CogniPilot/spinali_kicad_libs/README.md

# spinali_kicad_libs
For use in kicad8 or greater.

## Steps to use

Run the python script add_lib.py, for more input options pass -h.
