CogniPilot/spinali_kicad_libs/3dmodels/BMxxB-SRSR-TB/BM03B-SRSS-TB.STEP

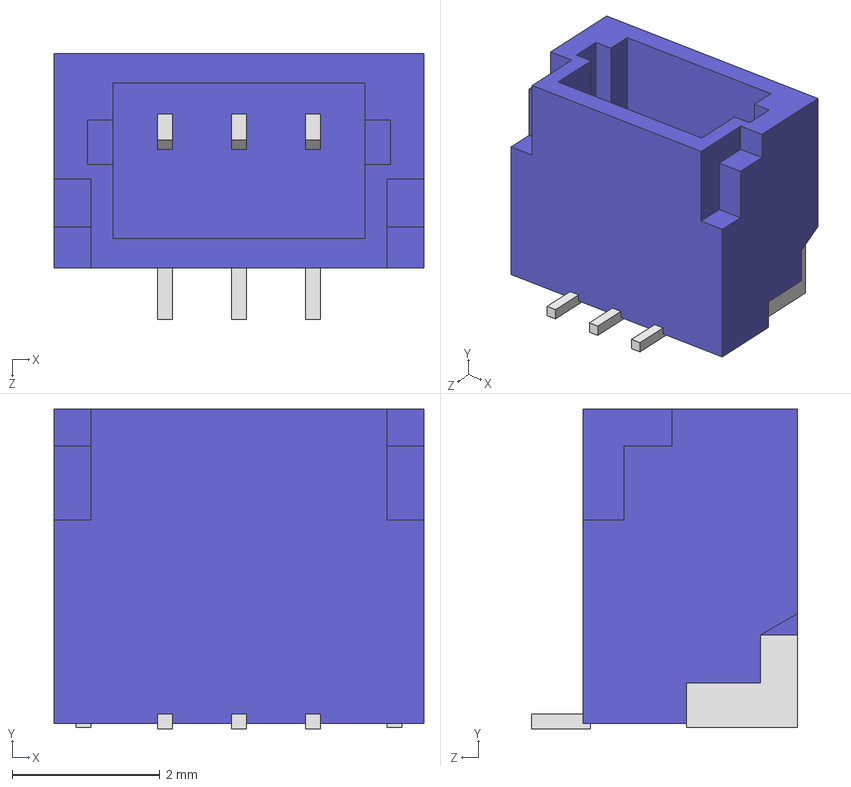
[picture p1: CAD file, 2025-08-25]
3dmodels/BMxxB-SRSR-TB/BM03B-SRSS-TB.STEP
5.00 x 4.32 x 3.60 mm
