CogniPilot/spinali_kicad_libs/3dmodels/SHR-xxV-S/SHR-11V-S.STEP

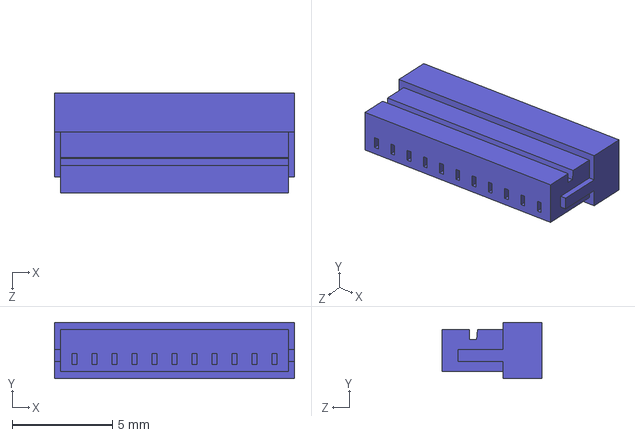
[picture p3: CAD file, 2025-08-25]
3dmodels/SHR-xxV-S/SHR-11V-S.STEP
12.0 x 2.80 x 5.00 mm
