CogniPilot/spinali_kicad_libs/3dmodels/SMxxB-SRSS-TB/SM13B-SRSS-TB.STEP

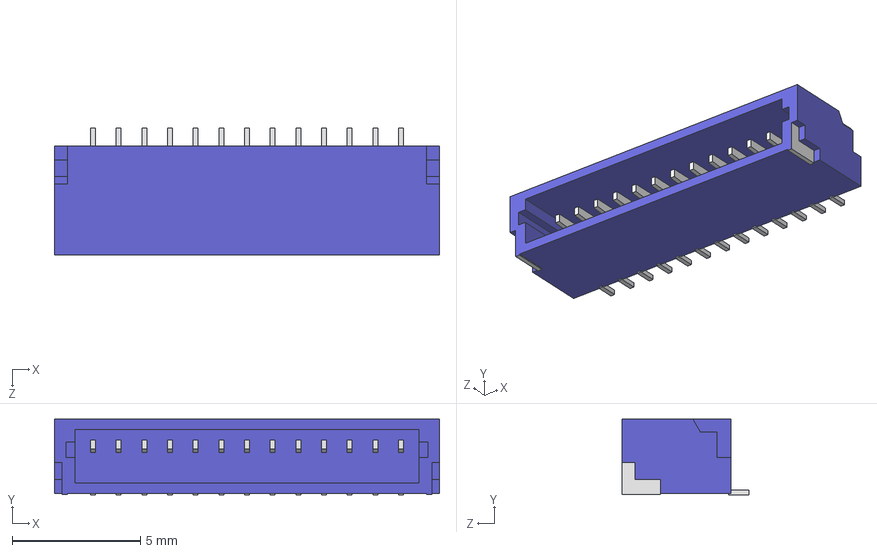
[picture p4: CAD file, 2025-08-25]
3dmodels/SMxxB-SRSS-TB/SM13B-SRSS-TB.STEP
15.0 x 2.96 x 4.95 mm
