CogniPilot/spinali_kicad_libs/3dmodels/SSH-003T-P0.2-H/SSH-003T-P0.2-H.STEP

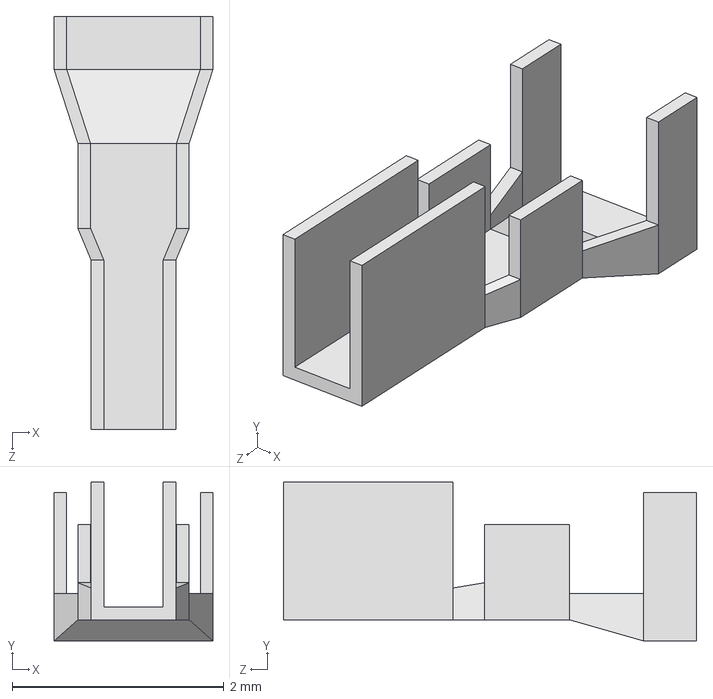
[picture p5: CAD file, 2025-08-25]
3dmodels/SSH-003T-P0.2-H/SSH-003T-P0.2-H.STEP
1.50 x 1.50 x 3.90 mm
