CogniPilot/spinali_kicad_libs/3dmodels/BMxxB-SRSR-TB/BM15B-SRSS-TB.STEP

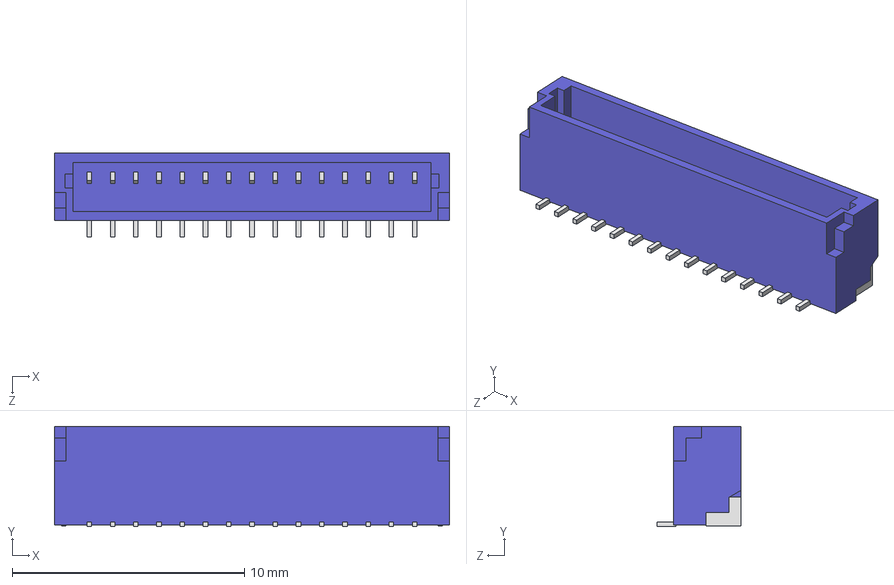
[picture p14: CAD file, 2025-08-25]
3dmodels/BMxxB-SRSR-TB/BM15B-SRSS-TB.STEP
17.0 x 4.32 x 3.60 mm
