CogniPilot/spinali_kicad_libs/3dmodels/GHR-04V-S.STEP

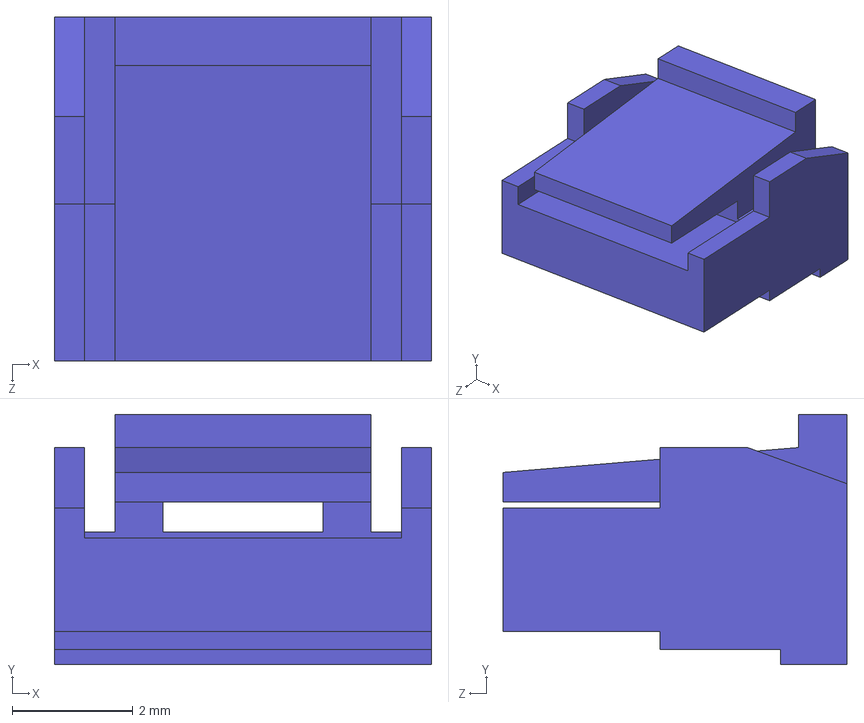
[picture p15: CAD file, 2025-08-25]
3dmodels/GHR-04V-S.STEP
6.25 x 4.15 x 5.70 mm
