CogniPilot/spinali_kicad_libs/3dmodels/SHR-xxV-S-B/SHR-04V-S-B.STEP

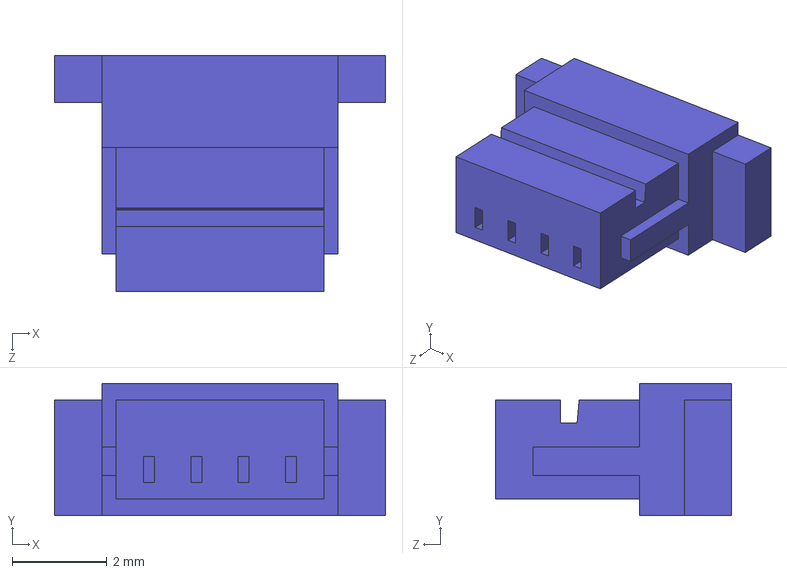
[picture p16: CAD file, 2025-08-25]
3dmodels/SHR-xxV-S-B/SHR-04V-S-B.STEP
7.00 x 2.80 x 5.00 mm
