CogniPilot/spinali_kicad_libs/3dmodels/EVQPU-LC-02K.STEP

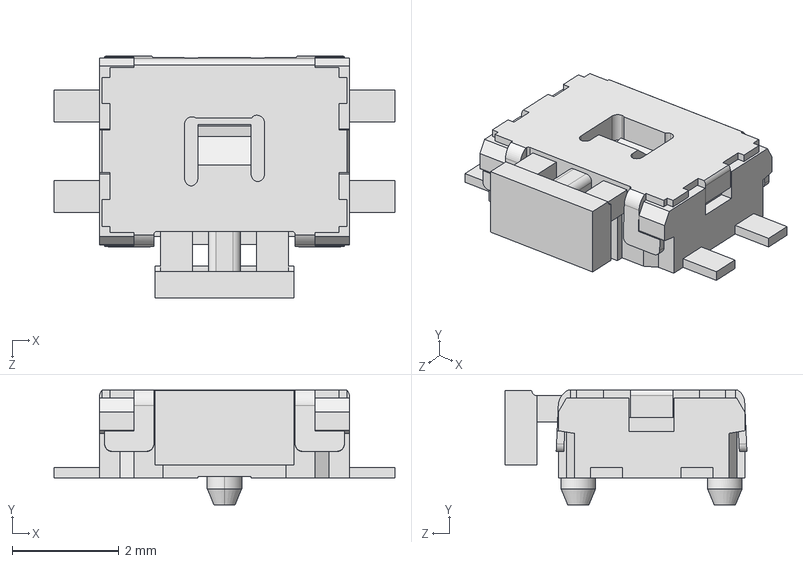
[picture p20: CAD file, 2025-08-21]
3dmodels/EVQPU-LC-02K.STEP
6.40 x 2.15 x 4.54 mm
