CogniPilot/spinali_kicad_libs/3dmodels/SHR-xxV-S/SHR-03V-S.STEP

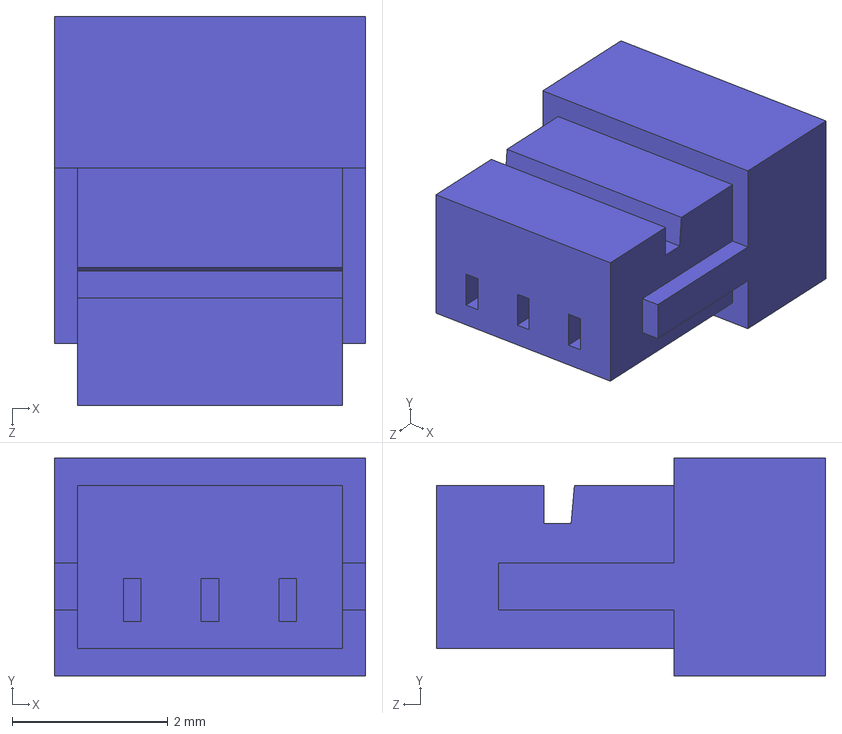
[picture p22: CAD file, 2025-08-25]
3dmodels/SHR-xxV-S/SHR-03V-S.STEP
4.00 x 2.80 x 5.00 mm
