CogniPilot/spinali_kicad_libs/3dmodels/SMxxB-SRSS-TB/SM03B-SRSS-TB.STEP

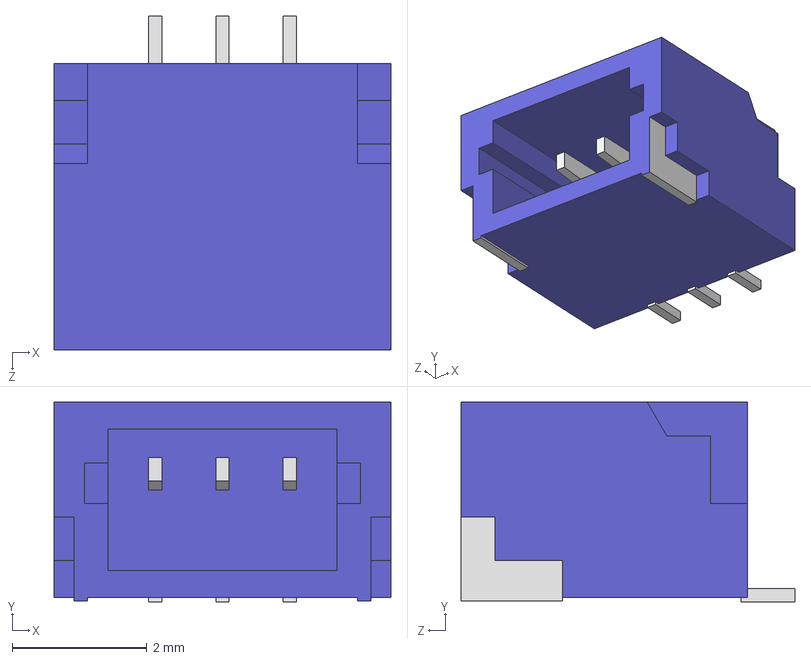
[picture p23: CAD file, 2025-08-25]
3dmodels/SMxxB-SRSS-TB/SM03B-SRSS-TB.STEP
5.00 x 2.96 x 4.95 mm
