CogniPilot/spinali_kicad_libs/3dmodels/NEO-F9P-15B.stp

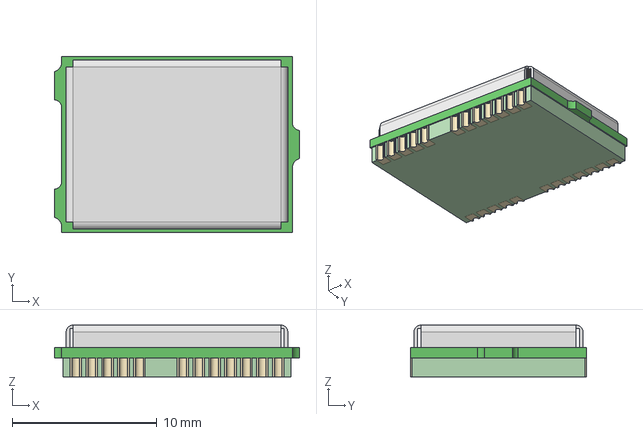
[picture p25: CAD file, 2025-07-10]
3dmodels/NEO-F9P-15B.stp
16.9 x 12.2 x 3.59 mm
