CogniPilot/spinali_kicad_libs/3dmodels/SHR-xxV-S-B/SHR-07V-S-B.STEP

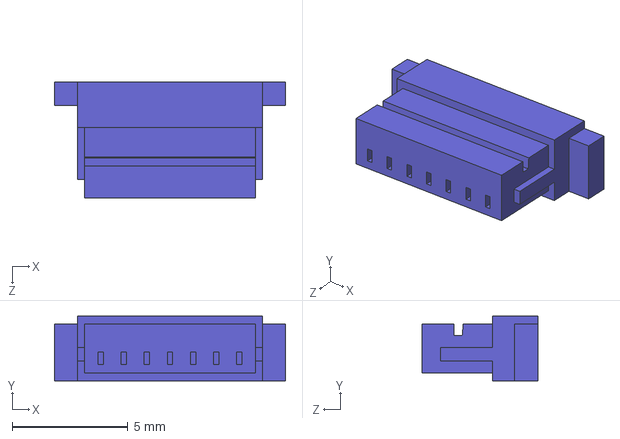
[picture p26: CAD file, 2025-08-25]
3dmodels/SHR-xxV-S-B/SHR-07V-S-B.STEP
10.0 x 2.80 x 5.00 mm
