CogniPilot/spinali_kicad_libs/3dmodels/BMxxB-SRSR-TB/BM10B-SRSS-TB.STEP

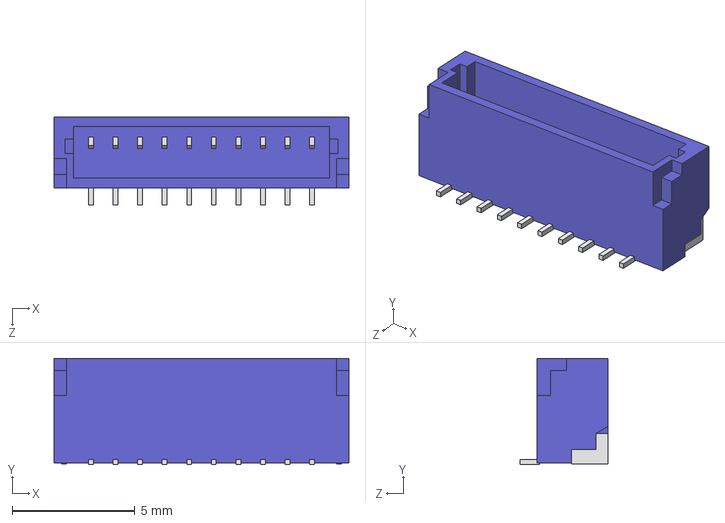
[picture p29: CAD file, 2025-08-25]
3dmodels/BMxxB-SRSR-TB/BM10B-SRSS-TB.STEP
12.0 x 4.32 x 3.60 mm
