CogniPilot/spinali_kicad_libs/3dmodels/PAA3905E1-Q.STEP

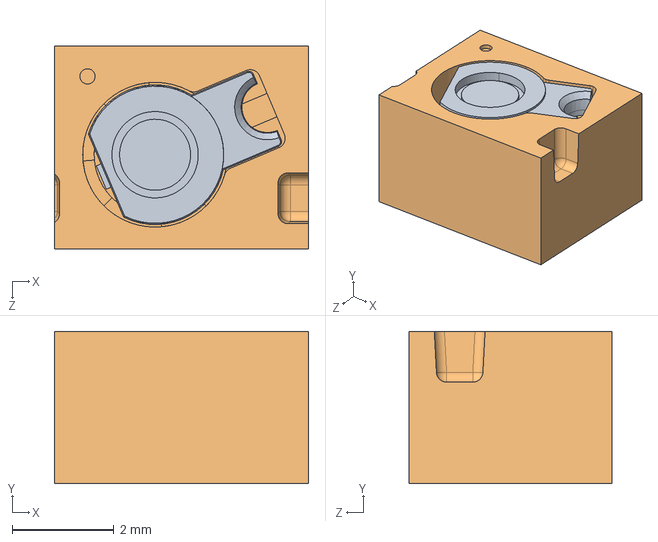
[picture p30: CAD file, 2025-04-24]
3dmodels/PAA3905E1-Q.STEP
5.00 x 3.00 x 4.00 mm
