CogniPilot/spinali_kicad_libs/3dmodels/SMxxB-SRSS-TB/SM02B-SRSS-TB.STEP

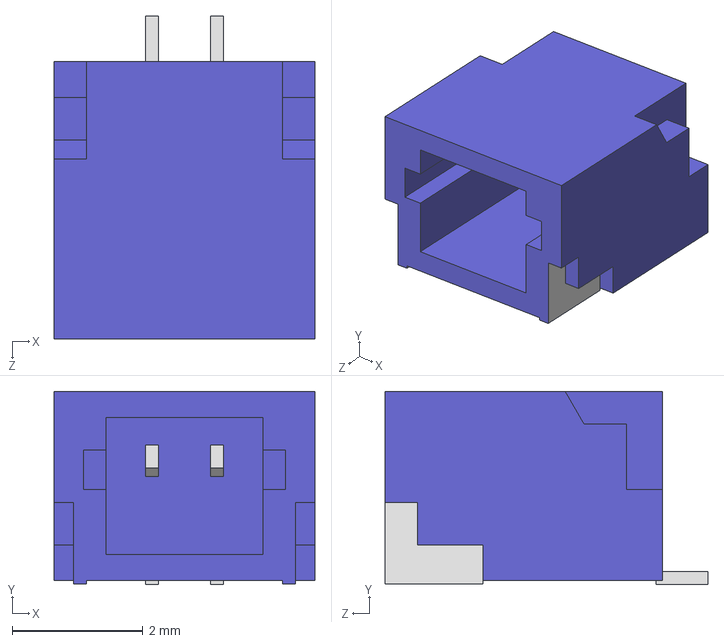
[picture p33: CAD file, 2025-08-25]
3dmodels/SMxxB-SRSS-TB/SM02B-SRSS-TB.STEP
4.00 x 2.96 x 4.95 mm
