CogniPilot/spinali_kicad_libs/3dmodels/ICM-42688-P.stp

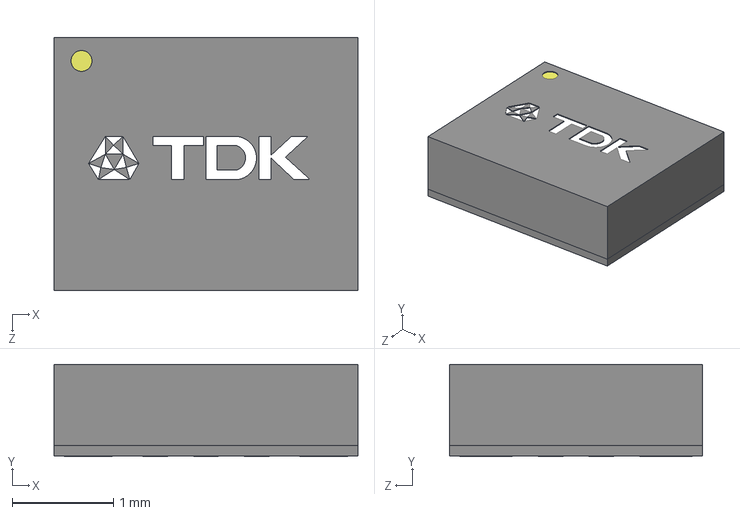
[picture p35: CAD file, 2025-04-23]
3dmodels/ICM-42688-P.stp
3.00 x 0.91 x 2.50 mm
