CogniPilot/spinali_kicad_libs/3dmodels/SHR-xxV-S-B/SHR-05V-S-B.STEP

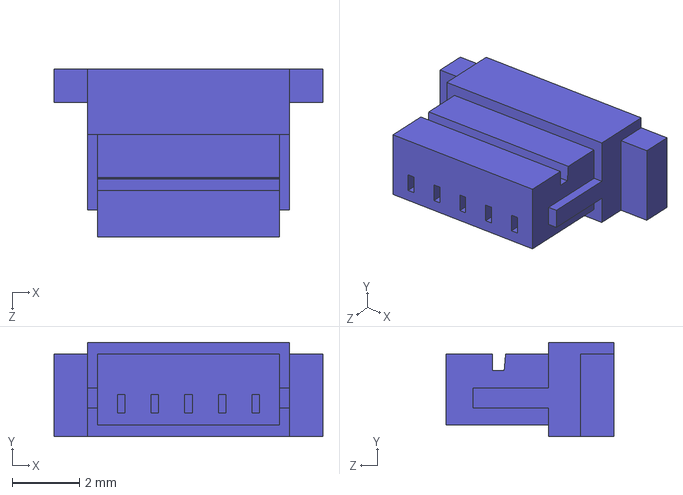
[picture p36: CAD file, 2025-08-25]
3dmodels/SHR-xxV-S-B/SHR-05V-S-B.STEP
8.00 x 2.80 x 5.00 mm
