CogniPilot/spinali_kicad_libs/3dmodels/SMxxB-SRSS-TB/SM06B-SRSS-TB.STEP

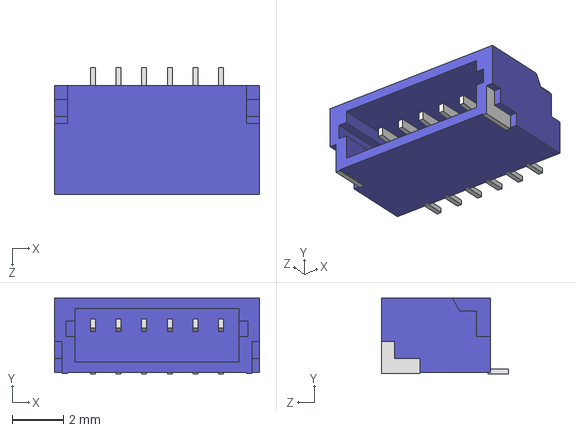
[picture p38: CAD file, 2025-08-25]
3dmodels/SMxxB-SRSS-TB/SM06B-SRSS-TB.STEP
8.00 x 2.96 x 4.95 mm
