CogniPilot/spinali_kicad_libs/3dmodels/ACT1210L-201-2P-TL00.stp

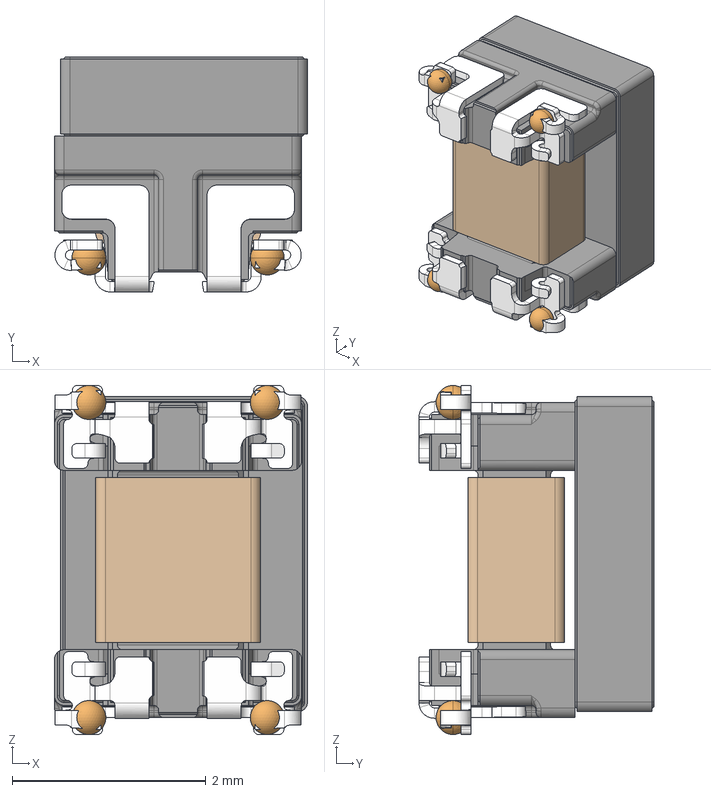
[picture p39: CAD file, 2025-03-26]
3dmodels/ACT1210L-201-2P-TL00.stp
2.61 x 2.42 x 3.60 mm
