CogniPilot/spinali_kicad_libs/3dmodels/BMxxB-SRSR-TB/BM13B-SRSS-TB.STEP

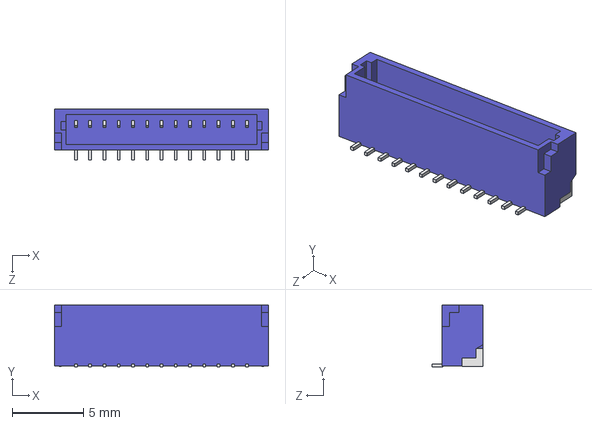
[picture p40: CAD file, 2025-08-25]
3dmodels/BMxxB-SRSR-TB/BM13B-SRSS-TB.STEP
15.0 x 4.32 x 3.60 mm
