CogniPilot/spinali_kicad_libs/3dmodels/BMxxB-SRSR-TB/BM11B-SRSS-TB.STEP

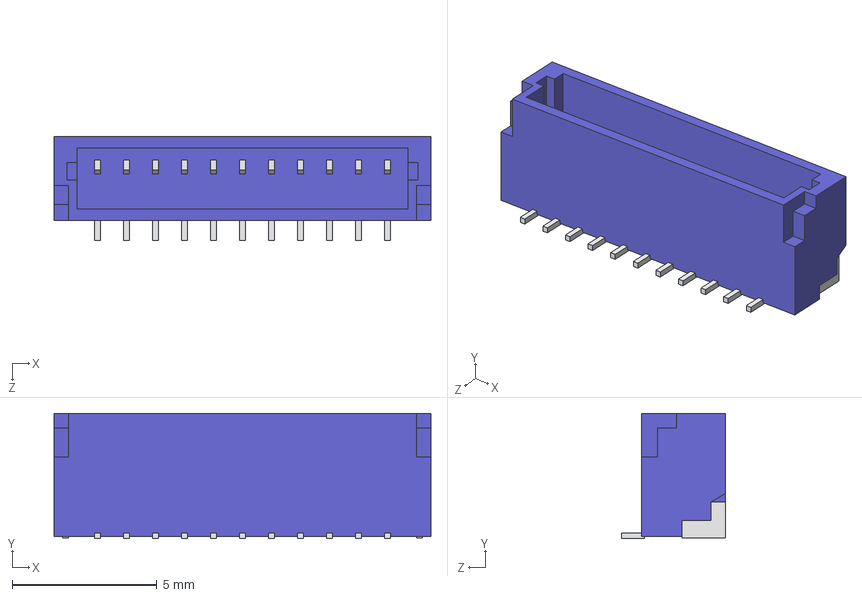
[picture p44: CAD file, 2025-08-25]
3dmodels/BMxxB-SRSR-TB/BM11B-SRSS-TB.STEP
13.0 x 4.32 x 3.60 mm
