CogniPilot/spinali_kicad_libs/3dmodels/SHR-xxV-S/SHR-14V-S.STEP

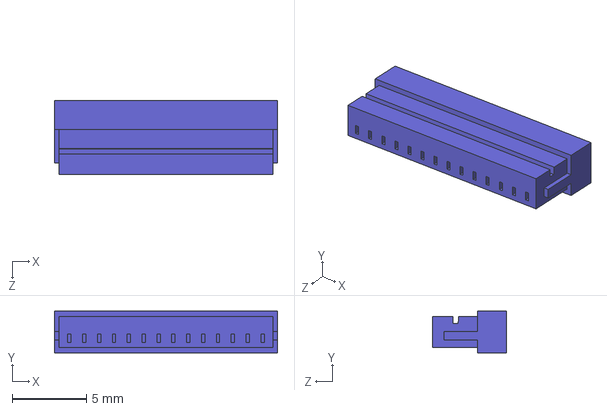
[picture p46: CAD file, 2025-08-25]
3dmodels/SHR-xxV-S/SHR-14V-S.STEP
15.0 x 2.80 x 5.00 mm
