CogniPilot/spinali_kicad_libs/3dmodels/SM10B-SRSS-TB_LF__SN_.stp

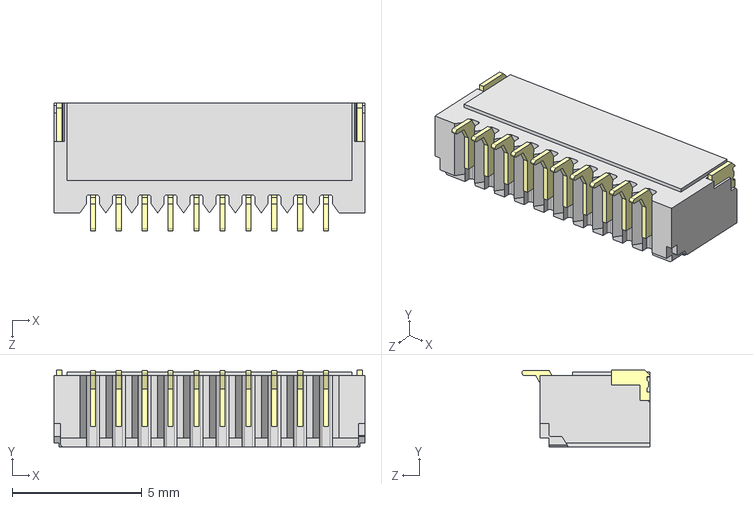
[picture p47: CAD file, 2025-03-20]
3dmodels/SM10B-SRSS-TB_LF__SN_.stp
12.0 x 2.97 x 4.95 mm
