CogniPilot/spinali_kicad_libs/3dmodels/PCMF1USB3SZ.stp

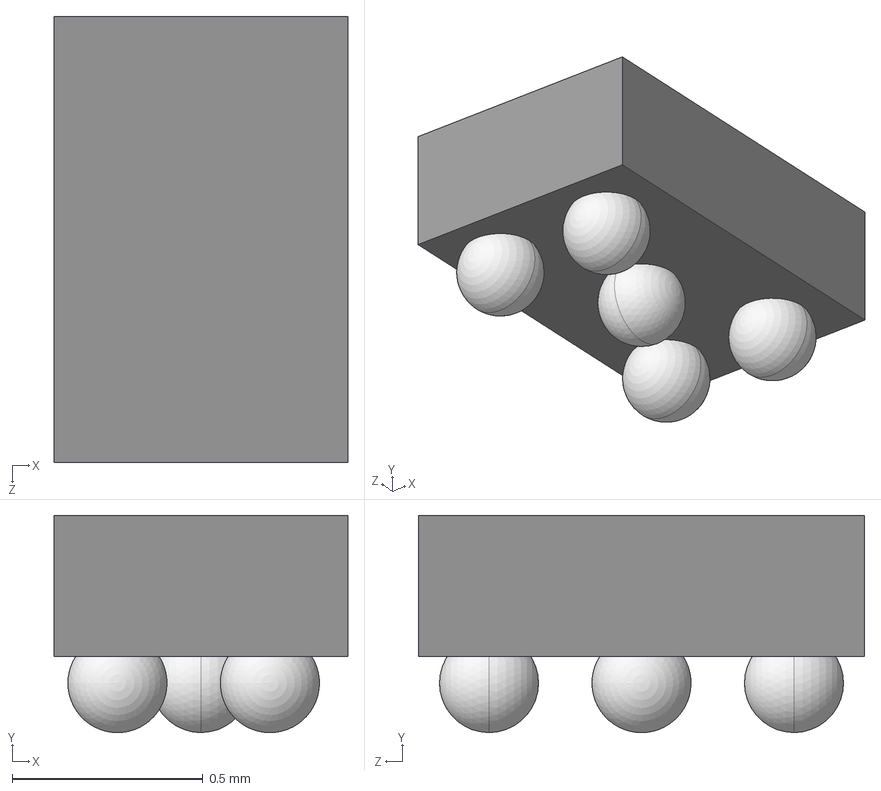
[picture p50: CAD file, 2025-03-20]
3dmodels/PCMF1USB3SZ.stp
0.77 x 0.57 x 1.17 mm
