CogniPilot/spinali_kicad_libs/3dmodels/SHR-xxV-S-B/SHR-20V-S-B.STEP

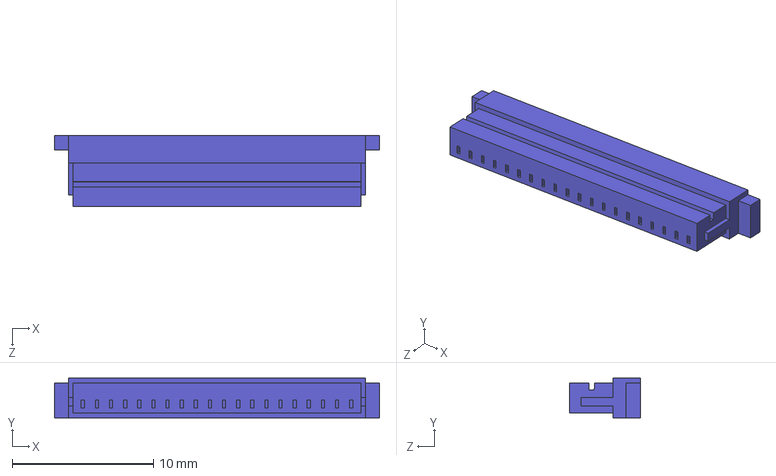
[picture p51: CAD file, 2025-08-25]
3dmodels/SHR-xxV-S-B/SHR-20V-S-B.STEP
23.0 x 2.80 x 5.00 mm
