CogniPilot/spinali_kicad_libs/3dmodels/SHR-xxV-S/SHR-09V-S.STEP

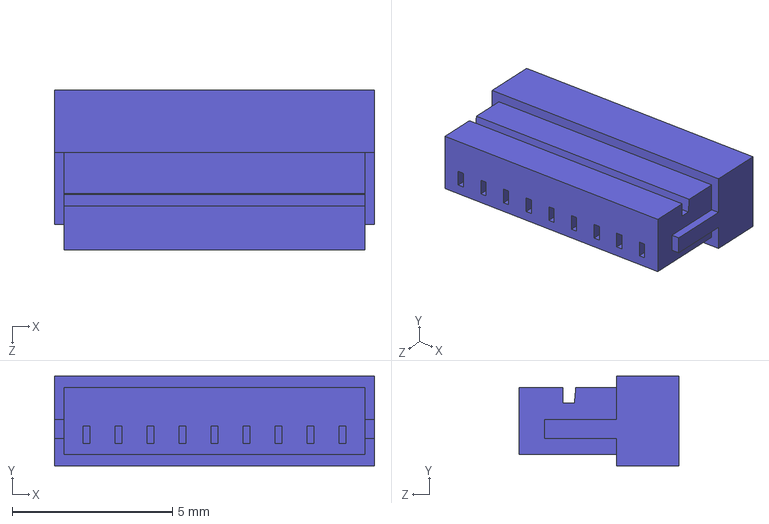
[picture p52: CAD file, 2025-08-25]
3dmodels/SHR-xxV-S/SHR-09V-S.STEP
10.0 x 2.80 x 5.00 mm
