CogniPilot/spinali_kicad_libs/3dmodels/SMxxB-SRSS-TB/SM07B-SRSS-TB.STEP

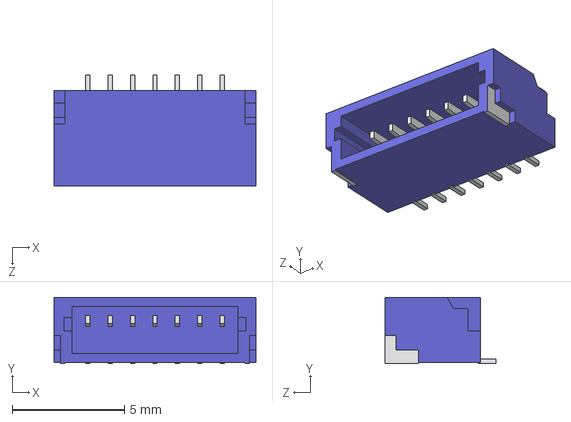
[picture p53: CAD file, 2025-08-25]
3dmodels/SMxxB-SRSS-TB/SM07B-SRSS-TB.STEP
9.00 x 2.96 x 4.95 mm
