CogniPilot/spinali_kicad_libs/3dmodels/6DFN62CA-M3_I.stp

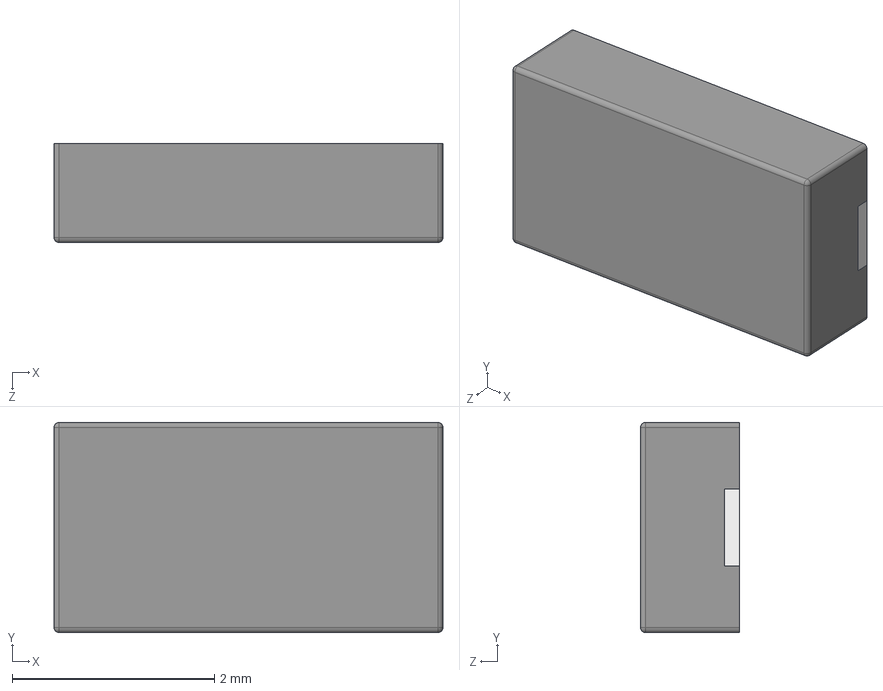
[picture p54: CAD file, 2025-03-20]
3dmodels/6DFN62CA-M3_I.stp
3.85 x 2.08 x 0.98 mm
