CogniPilot/spinali_kicad_libs/3dmodels/SHR-xxV-S-B/SHR-10V-S-B.STEP

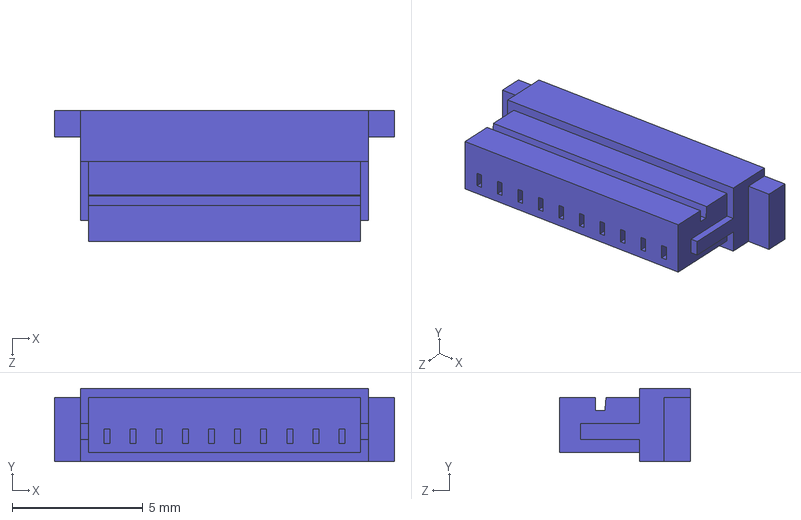
[picture p56: CAD file, 2025-08-25]
3dmodels/SHR-xxV-S-B/SHR-10V-S-B.STEP
13.0 x 2.80 x 5.00 mm
