CogniPilot/spinali_kicad_libs/3dmodels/SHR-xxV-S/SHR-06V-S.STEP

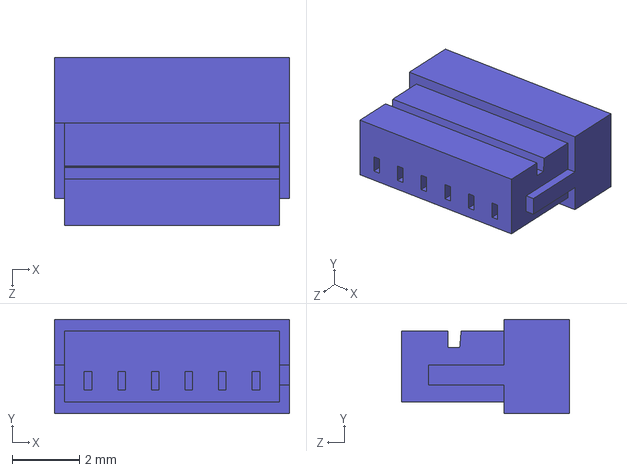
[picture p57: CAD file, 2025-08-25]
3dmodels/SHR-xxV-S/SHR-06V-S.STEP
7.00 x 2.80 x 5.00 mm
