CogniPilot/spinali_kicad_libs/3dmodels/SMxxB-SRSS-TB/SM20B-SRSS-TB.STEP

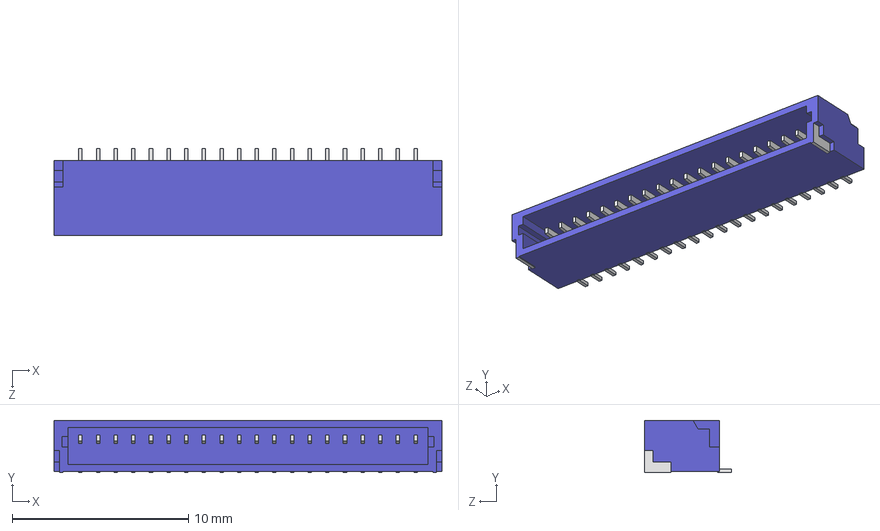
[picture p58: CAD file, 2025-08-25]
3dmodels/SMxxB-SRSS-TB/SM20B-SRSS-TB.STEP
22.0 x 2.96 x 4.95 mm
