CogniPilot/spinali_kicad_libs/3dmodels/BMxxB-SRSR-TB/BM08B-SRSS-TB.STEP

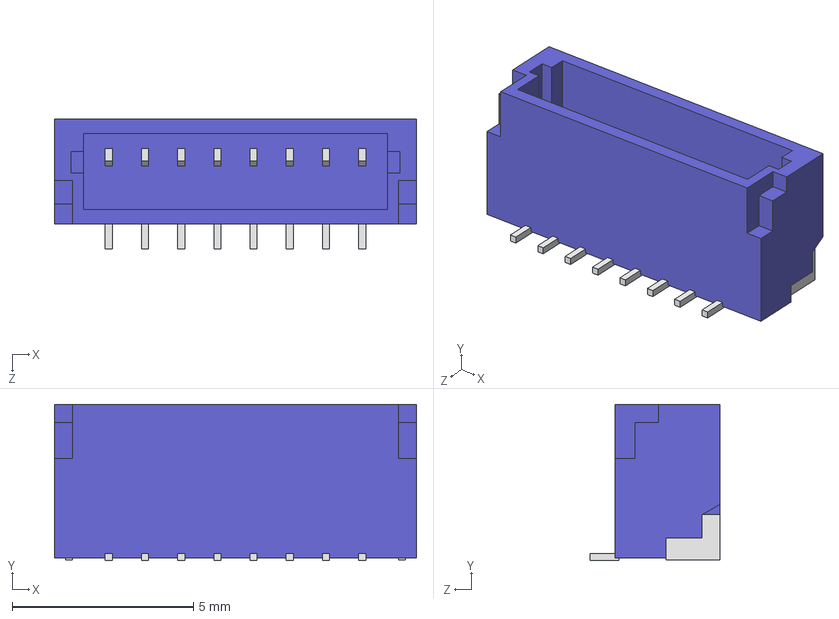
[picture p59: CAD file, 2025-08-25]
3dmodels/BMxxB-SRSR-TB/BM08B-SRSS-TB.STEP
10.0 x 4.32 x 3.60 mm
