CogniPilot/spinali_kicad_libs/3dmodels/PCMF3USB3S_CZ.stp

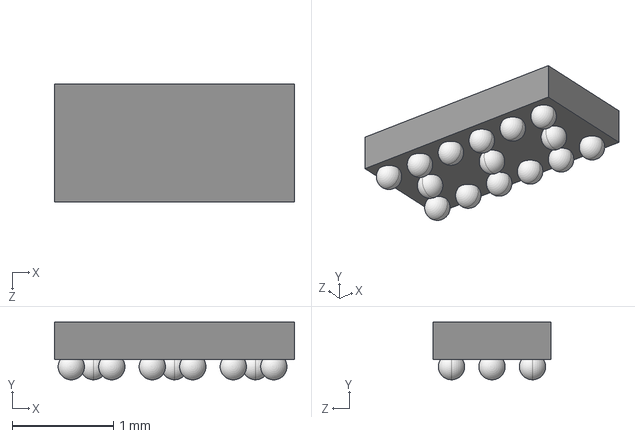
[picture p60: CAD file, 2025-03-20]
3dmodels/PCMF3USB3S_CZ.stp
2.37 x 0.57 x 1.17 mm
