CogniPilot/spinali_kicad_libs/3dmodels/SHR-xxV-S-B/SHR-08V-S-B.STEP

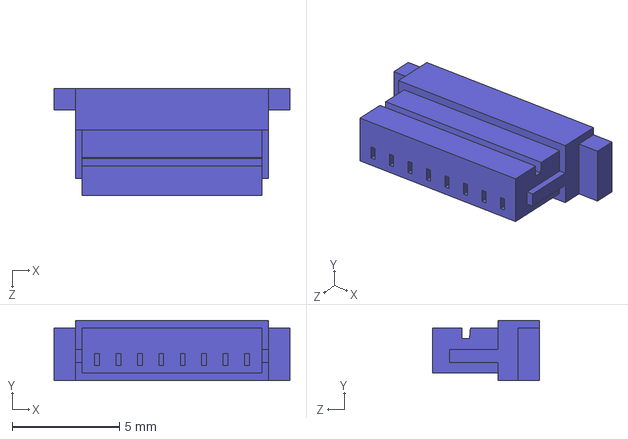
[picture p61: CAD file, 2025-08-25]
3dmodels/SHR-xxV-S-B/SHR-08V-S-B.STEP
11.0 x 2.80 x 5.00 mm
