CogniPilot/spinali_kicad_libs/3dmodels/SHR-xxV-S/SHR-12V-S.STEP

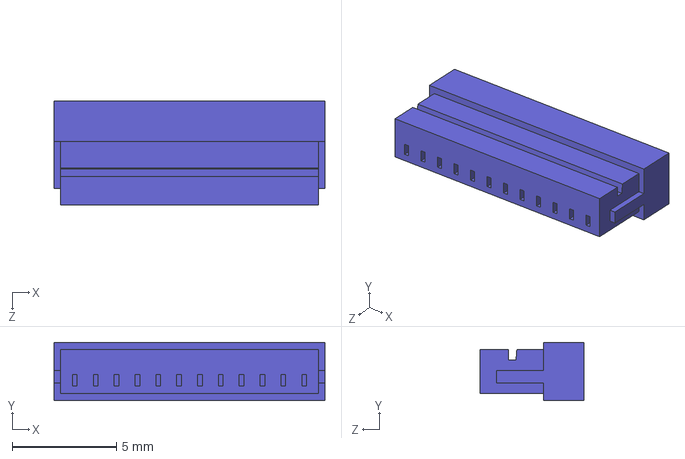
[picture p62: CAD file, 2025-08-25]
3dmodels/SHR-xxV-S/SHR-12V-S.STEP
13.0 x 2.80 x 5.00 mm
