CogniPilot/spinali_kicad_libs/3dmodels/BMxxB-SRSR-TB/BM09B-SRSS-TB.STEP

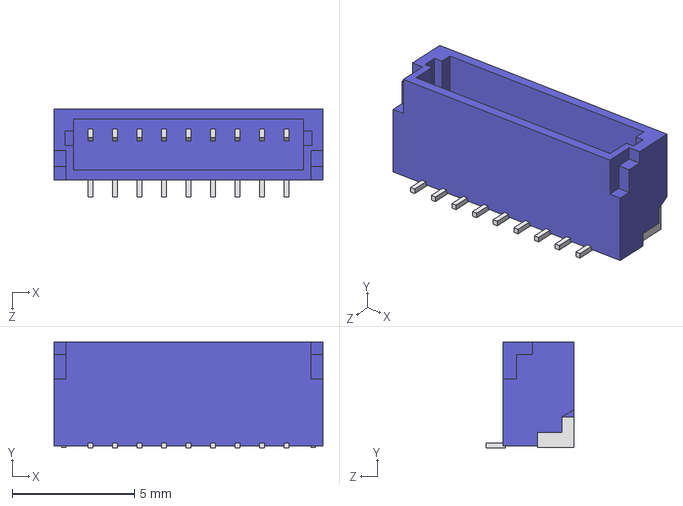
[picture p64: CAD file, 2025-08-25]
3dmodels/BMxxB-SRSR-TB/BM09B-SRSS-TB.STEP
11.0 x 4.32 x 3.60 mm
