CogniPilot/spinali_kicad_libs/3dmodels/SHR-xxV-S-B/SHR-06V-S-B.STEP

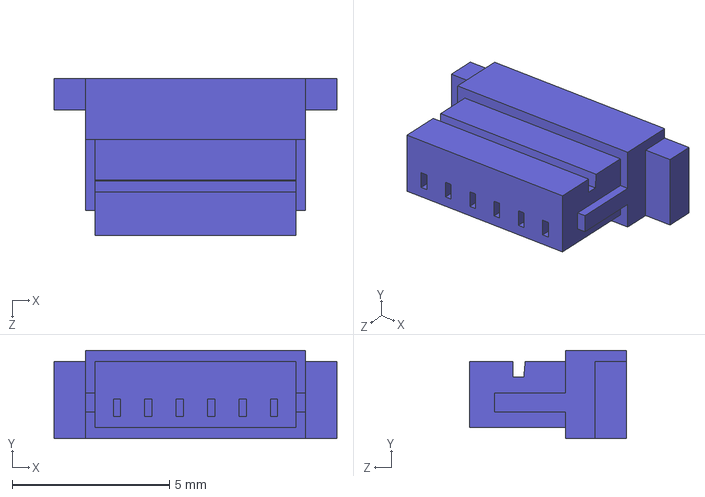
[picture p65: CAD file, 2025-08-25]
3dmodels/SHR-xxV-S-B/SHR-06V-S-B.STEP
9.00 x 2.80 x 5.00 mm
