CogniPilot/spinali_kicad_libs/3dmodels/SMxxB-SRSS-TB/SM12B-SRSS-TB.STEP

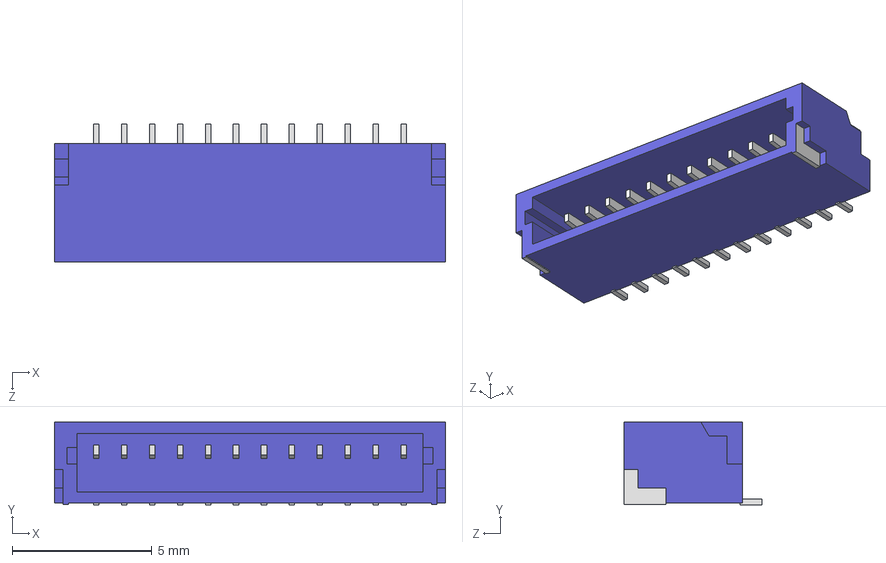
[picture p67: CAD file, 2025-08-25]
3dmodels/SMxxB-SRSS-TB/SM12B-SRSS-TB.STEP
14.0 x 2.96 x 4.95 mm
