CogniPilot/spinali_kicad_libs/3dmodels/PESD5V0S1ULD,315.stp

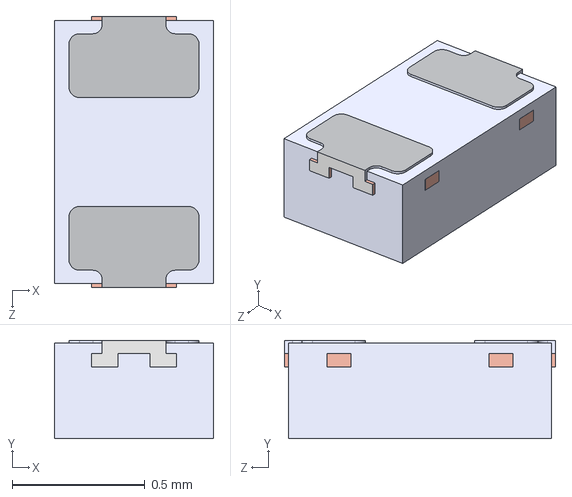
[picture p68: CAD file, 2025-03-20]
3dmodels/PESD5V0S1ULD,315.stp
0.6 x 0.37 x 1.02 mm
SOD882D LF
SOD882D Body
