CogniPilot/spinali_kicad_libs/3dmodels/SMxxB-SRSS-TB/SM10B-SRSS-TB.STEP

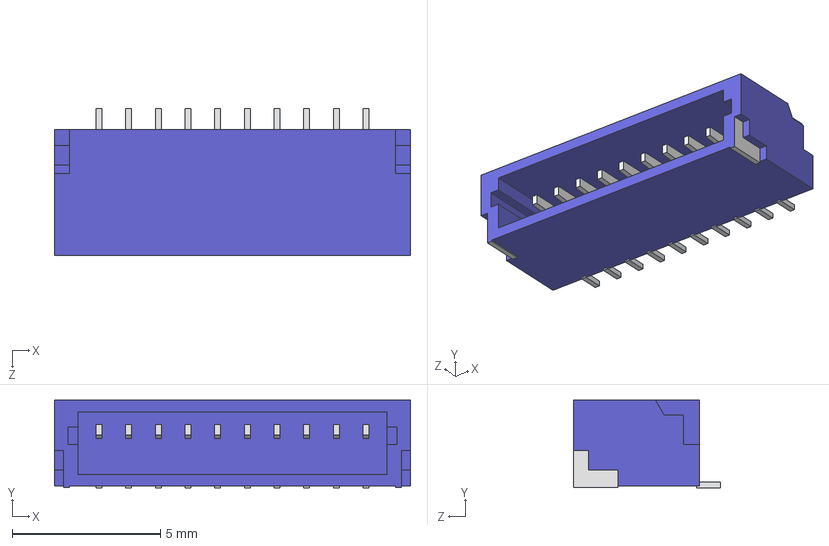
[picture p70: CAD file, 2025-08-25]
3dmodels/SMxxB-SRSS-TB/SM10B-SRSS-TB.STEP
12.0 x 2.96 x 4.95 mm
