CogniPilot/spinali_kicad_libs/3dmodels/TS2306A-240GF-MSM-9_C388290.stp

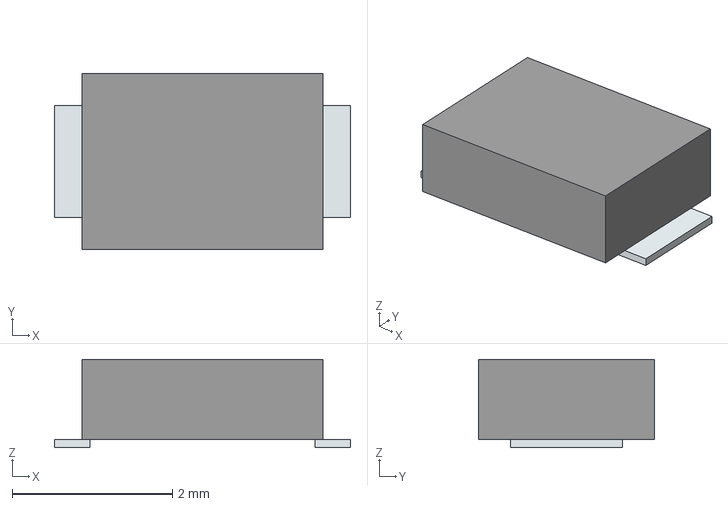
[picture p71: CAD file, 2025-03-20]
3dmodels/TS2306A-240GF-MSM-9_C388290.stp
3.69 x 2.20 x 1.10 mm
Pins
