CogniPilot/spinali_kicad_libs/3dmodels/DF40TC-50DP-0.4V(51).stp

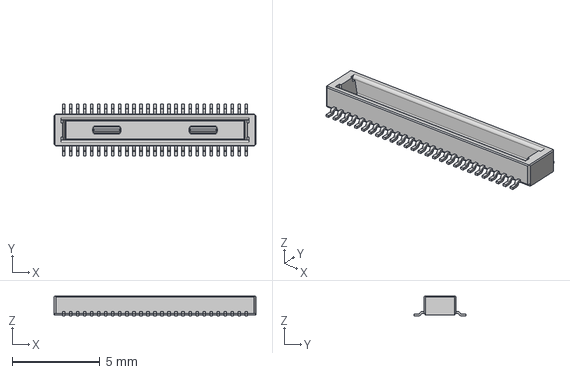
[picture p72: CAD file, 2025-03-18]
3dmodels/DF40TC-50DP-0.4V(51).stp
11.5 x 2.97 x 1.14 mm
