CogniPilot/spinali_kicad_libs/3dmodels/XRCGB25M000F3A00R0.stp

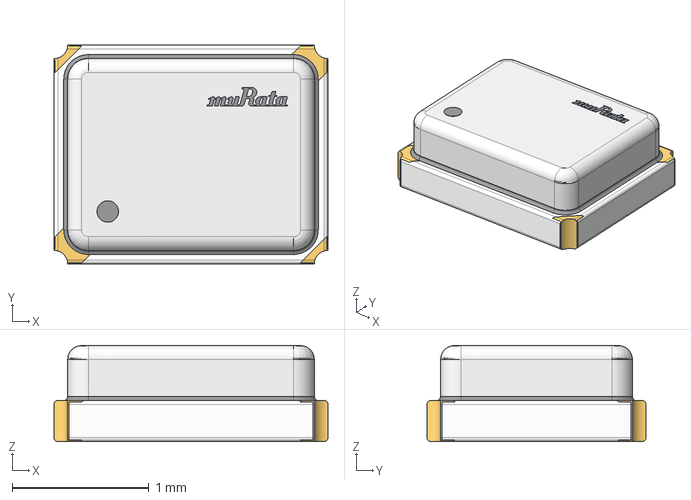
[picture p73: CAD file, 2025-03-18]
3dmodels/XRCGB25M000F3A00R0.stp
2.00 x 1.60 x 0.702 mm
