CogniPilot/spinali_kicad_libs/3dmodels/NANOT160AS.stp

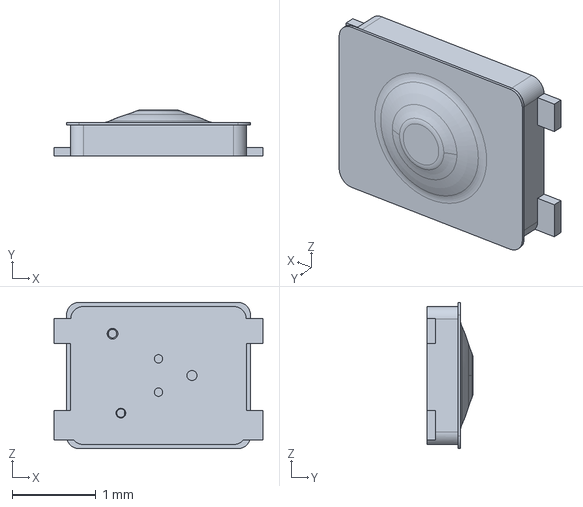
[picture p74: CAD file, 2025-03-18]
3dmodels/NANOT160AS.stp
2.50 x 0.55 x 1.75 mm
