CogniPilot/spinali_kicad_libs/3dmodels/ACM7060-301-2PL-TL01.stp

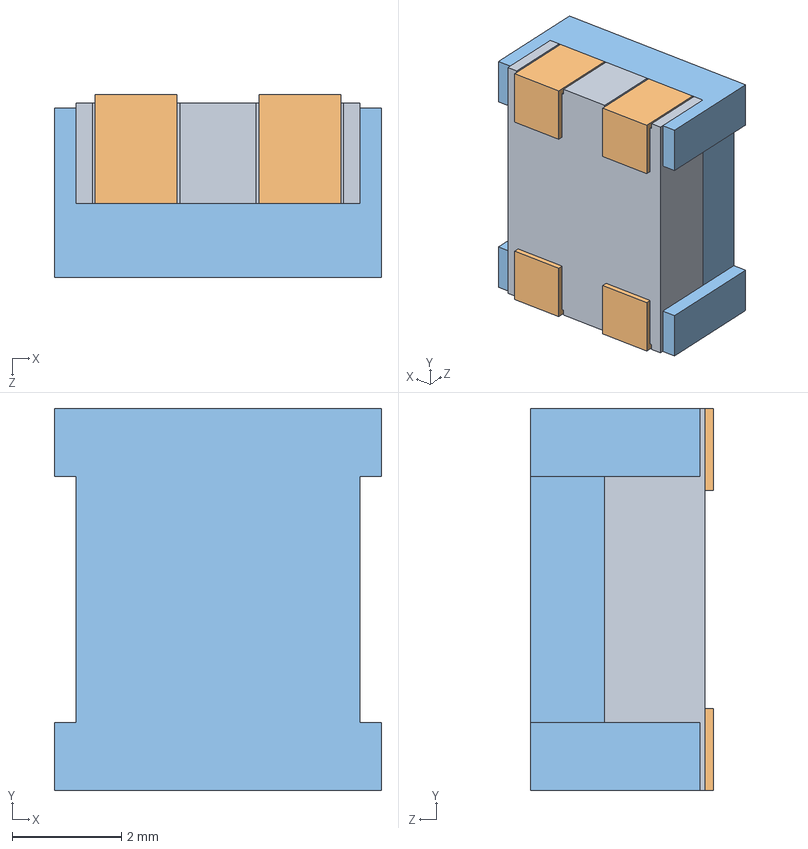
[picture p75: CAD file, 2025-03-18]
3dmodels/ACM7060-301-2PL-TL01.stp
6.00 x 7.00 x 3.35 mm
ACM70Vコアblock(typ size)
ACM70V端子block(typ size) x 4
ACM70Vカバblock(typ size)
