CogniPilot/spinali_kicad_libs/3dmodels/DF40TC(3.0)-50DP-0.4V(51).STEP

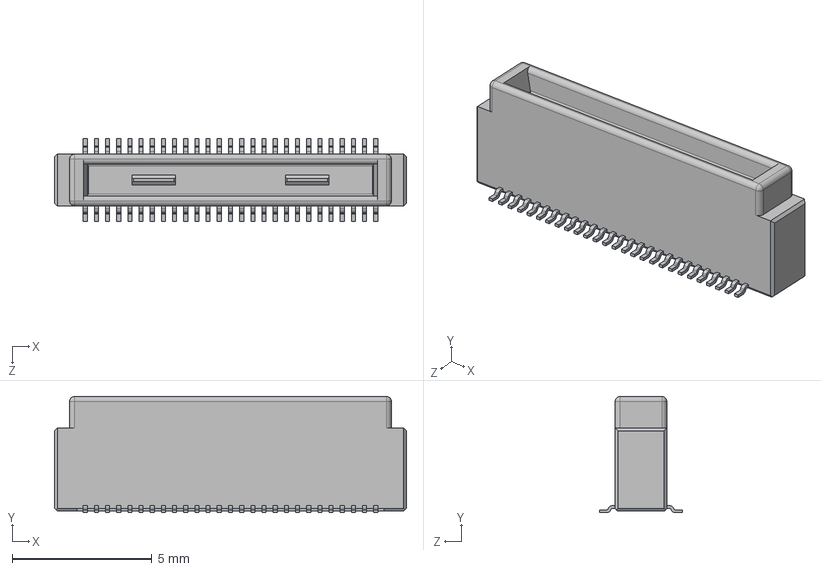
[picture p77: CAD file, 2025-03-18]
3dmodels/DF40TC(3.0)-50DP-0.4V(51).STEP
12.6 x 4.16 x 2.97 mm
