CogniPilot/spinali_kicad_libs/3dmodels/ESD7104MUTAG.stp

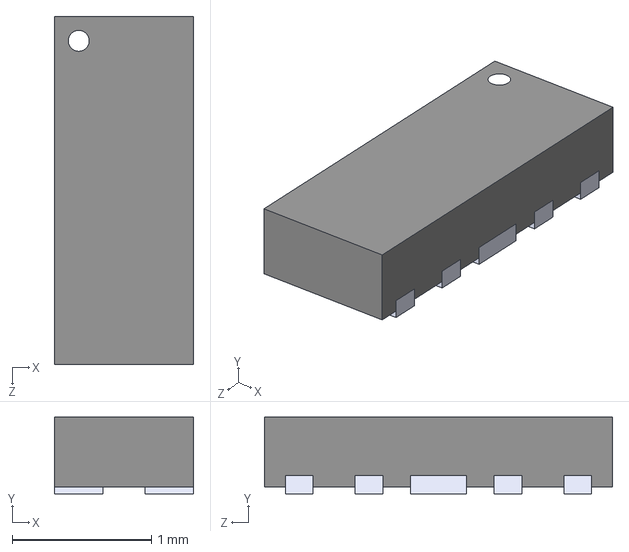
[picture p79: CAD file, 2025-03-18]
3dmodels/ESD7104MUTAG.stp
1.00 x 0.55 x 2.50 mm
