CogniPilot/spinali_kicad_libs/3dmodels/DF40TC(4.0)-50DS-0.4V(51).stp

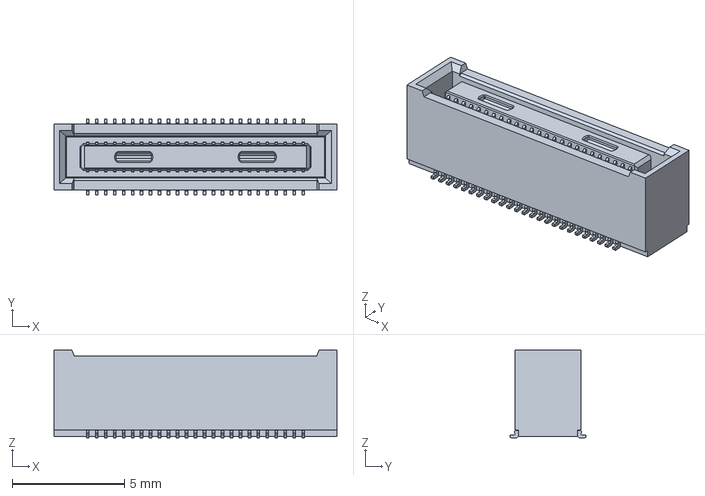
[picture p80: CAD file, 2025-03-18]
3dmodels/DF40TC(4.0)-50DS-0.4V(51).stp
12.6 x 3.38 x 3.90 mm
