CogniPilot/spinali_kicad_libs/3dmodels/IFLN1210BEER512N.stp

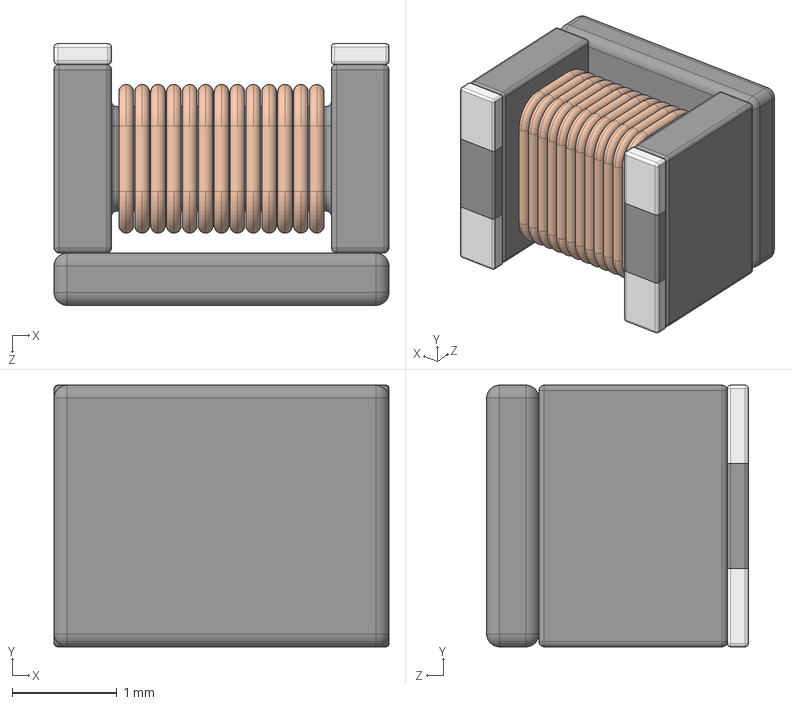
[picture p81: CAD file, 2025-03-13]
3dmodels/IFLN1210BEER512N.stp
3.20 x 2.50 x 2.50 mm
