CogniPilot/spinali_kicad_libs/3dmodels/PESD2IVN24-UX.stp

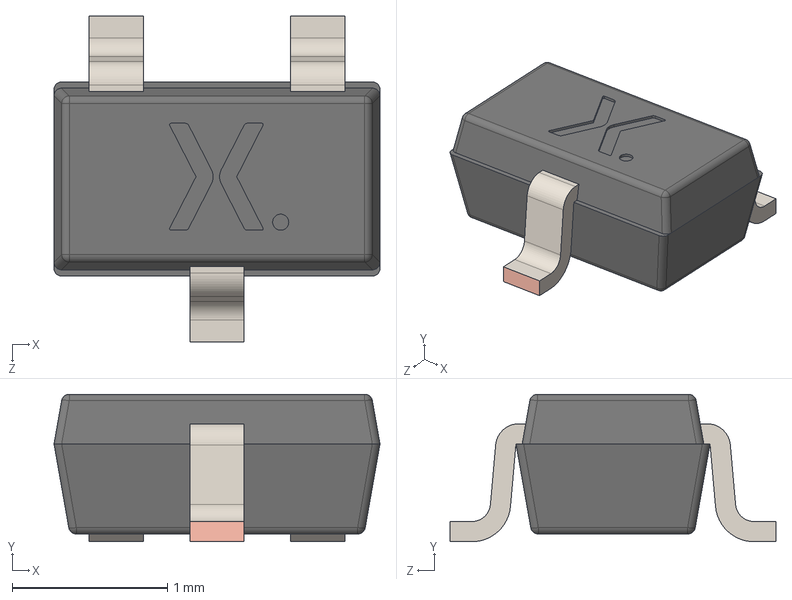
[picture p82: CAD file, 2025-03-12]
3dmodels/PESD2IVN24-UX.stp
2.10 x 0.95 x 2.10 mm
Upper body
lower body
Lead x 3
