CogniPilot/spinali_kicad_libs/3dmodels/BMM350.stp

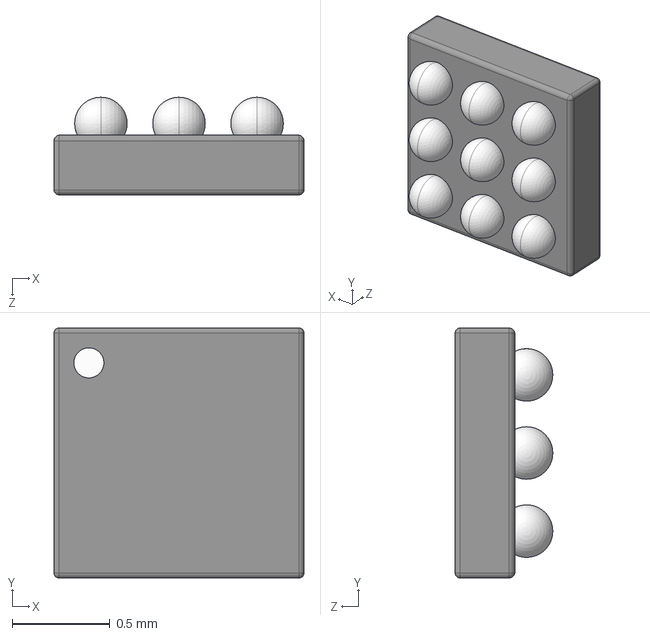
[picture p83: CAD file, 2025-03-12]
3dmodels/BMM350.stp
1.28 x 1.28 x 0.5 mm
