CogniPilot/spinali_kicad_libs/3dmodels/NFM31KC153R1H3L.stp

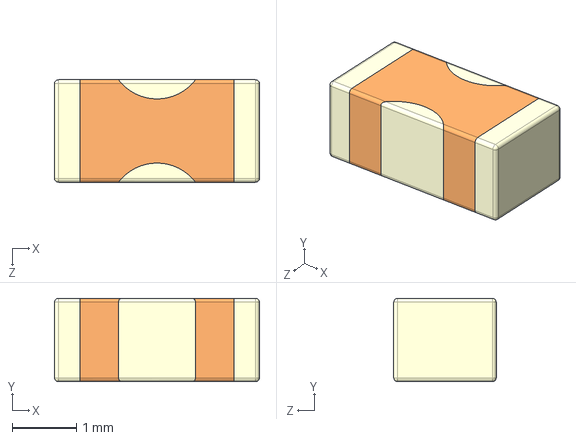
[picture p84: CAD file, 2025-03-12]
3dmodels/NFM31KC153R1H3L.stp
3.20 x 1.30 x 1.60 mm
