CogniPilot/spinali_kicad_libs/3dmodels/BMP581.stp

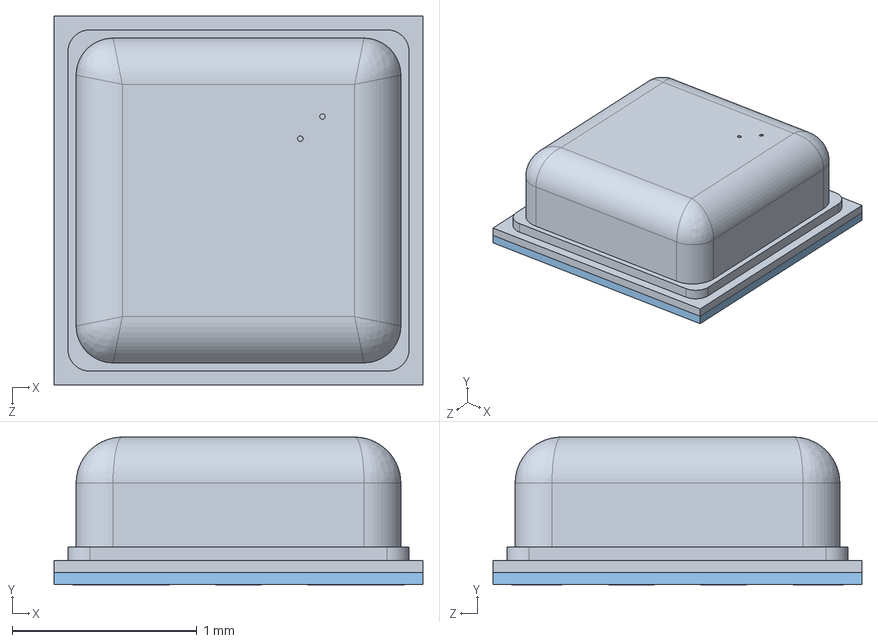
[picture p85: CAD file, 2025-03-12]
3dmodels/BMP581.stp
2.00 x 0.801 x 2.00 mm
