CogniPilot/spinali_kicad_libs/3dmodels/NX5P3363UKZ.stp

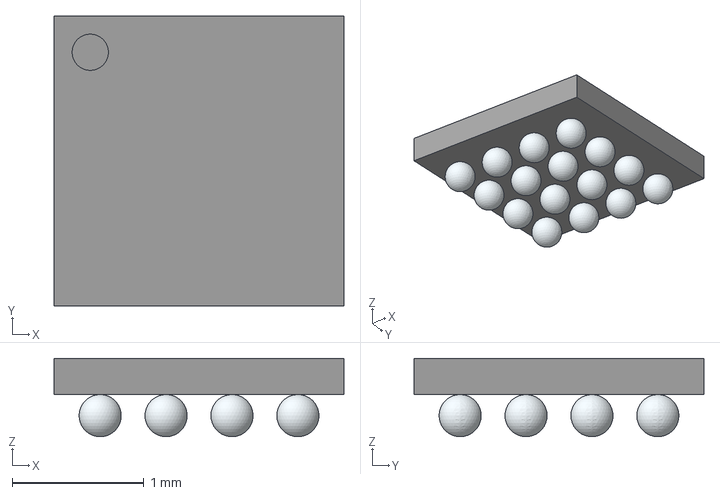
[picture p86: CAD file, 2025-03-12]
3dmodels/NX5P3363UKZ.stp
2.20 x 2.20 x 0.595 mm
