CogniPilot/spinali_kicad_libs/3dmodels/MPM3822CGRH.step

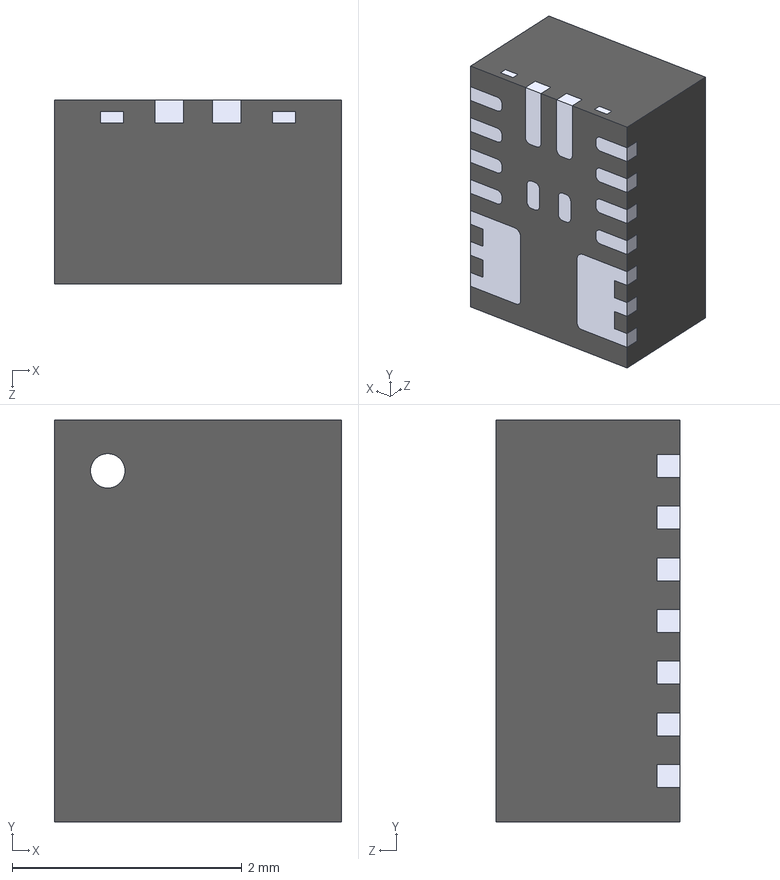
[picture p87: CAD file, 2025-03-12]
3dmodels/MPM3822CGRH.step
2.50 x 3.50 x 1.60 mm
