CogniPilot/spinali_kicad_libs/3dmodels/VQFN32_PHA_MCH.step

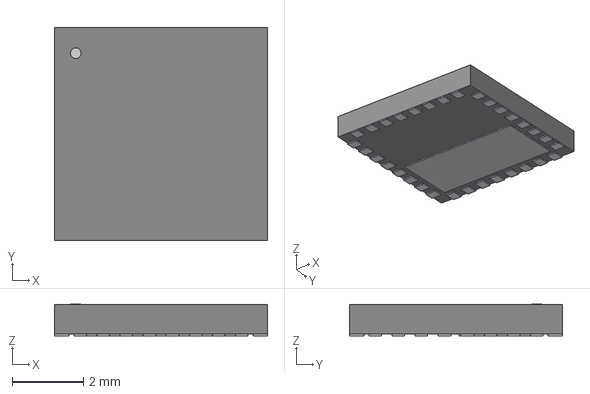
[picture p88: CAD file, 2025-03-12]
3dmodels/VQFN32_PHA_MCH.step
5.99 x 5.99 x 0.892 mm
