CogniPilot/spinali_kicad_libs/3dmodels/ACP3225-102-2P-T000.stp

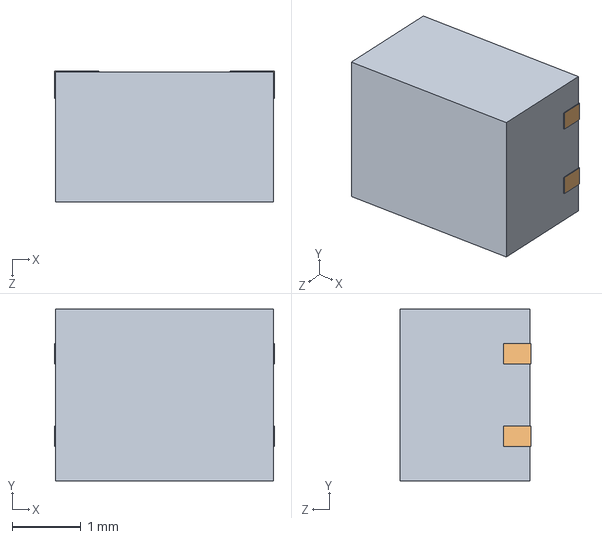
[picture p90: CAD file, 2025-03-12]
3dmodels/ACP3225-102-2P-T000.stp
3.20 x 2.50 x 1.90 mm
ACP3225-T000 DRコアブロック(typ size)
ACP3225-T000 電極ブロック(typ size) x 4
