CogniPilot/spinali_kicad_libs/3dmodels/VLS5045EX-330M-H.stp

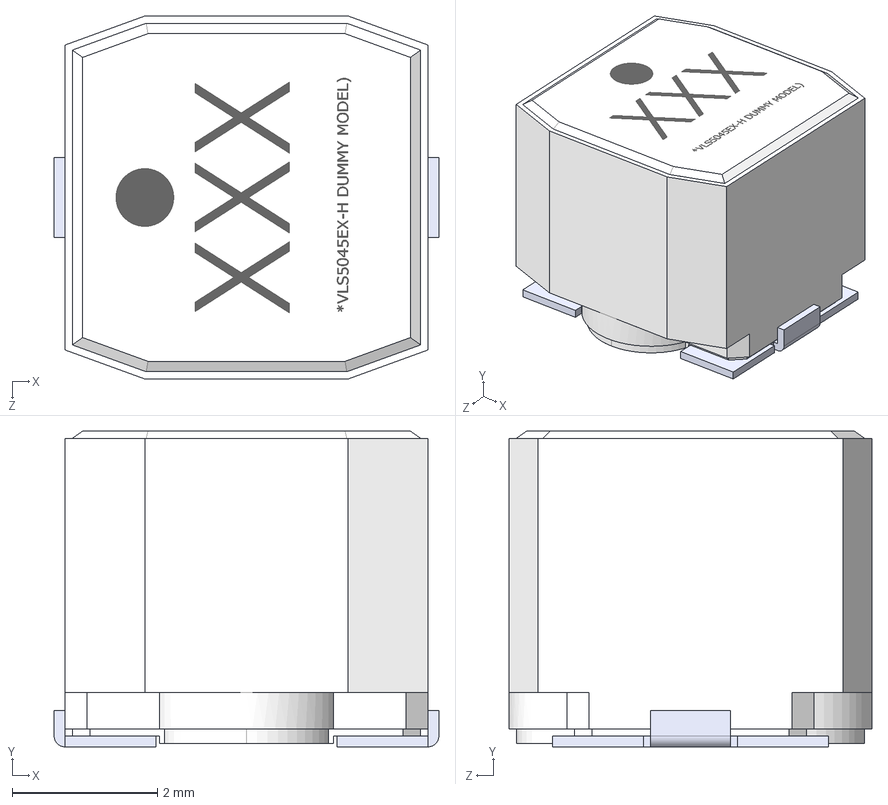
[picture p91: CAD file, 2025-03-12]
3dmodels/VLS5045EX-330M-H.stp
5.30 x 4.35 x 5.00 mm
VLS5045EX-H_C(3Dmodel)
VLS5045EX-H_T(3Dmodel)
