CogniPilot/spinali_kicad_libs/3dmodels/DF40C-30DP-0.4V_51_.stp

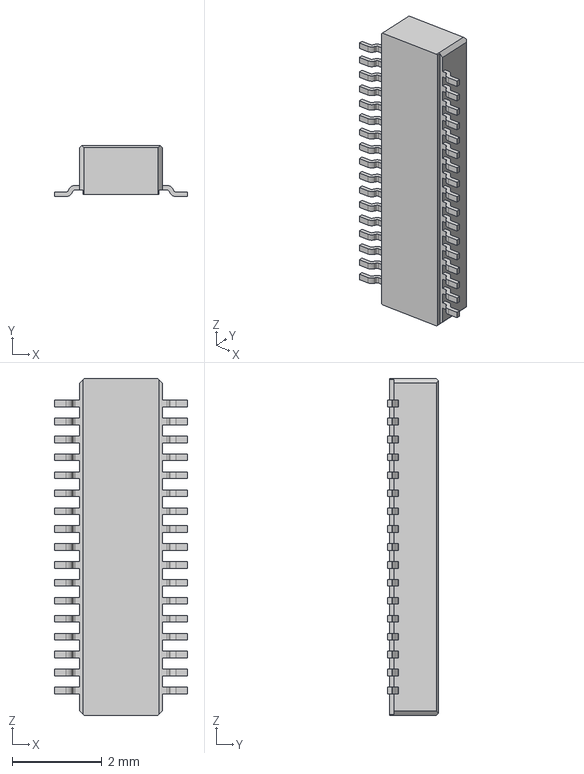
[picture p92: CAD file, 2025-02-22]
3dmodels/DF40C-30DP-0.4V_51_.stp
2.97 x 1.14 x 7.52 mm
