CogniPilot/spinali_kicad_libs/3dmodels/10LGA_2X2X0p75_BOS.step

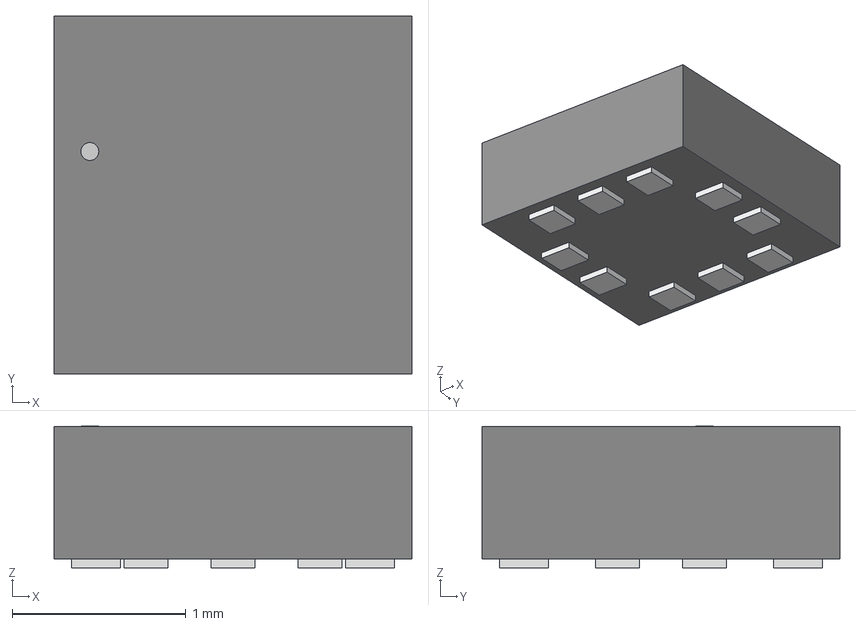
[picture p93: CAD file, 2025-01-15]
3dmodels/10LGA_2X2X0p75_BOS.step
2.06 x 2.06 x 0.815 mm
