CogniPilot/spinali_kicad_libs/3dmodels/PAA3905.step

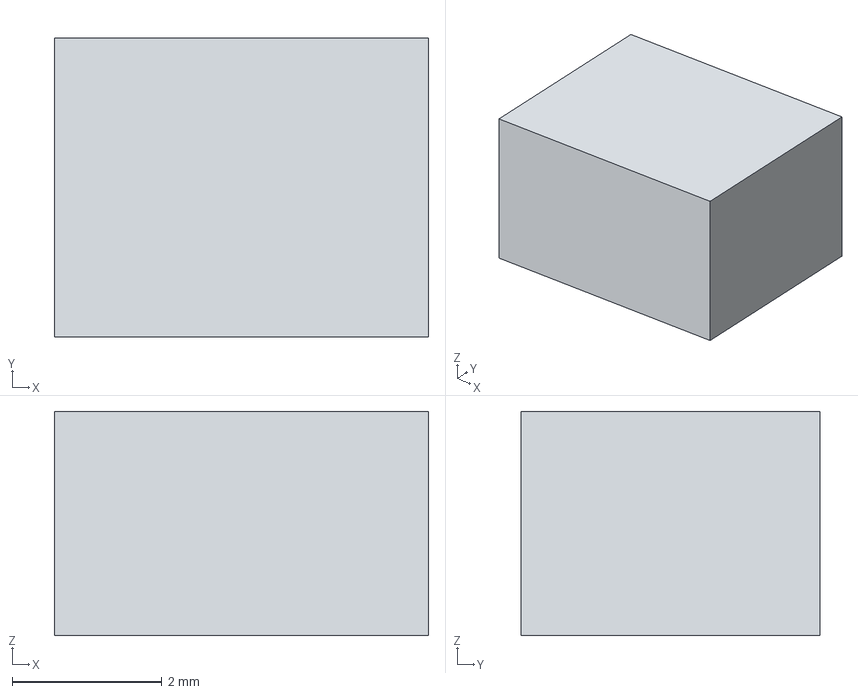
[picture p94: CAD file, 2025-01-15]
3dmodels/PAA3905.step
5.00 x 4.00 x 3.00 mm
