CogniPilot/spinali_kicad_libs/3dmodels/HVQFN36_SOT1092-2_NXP.step

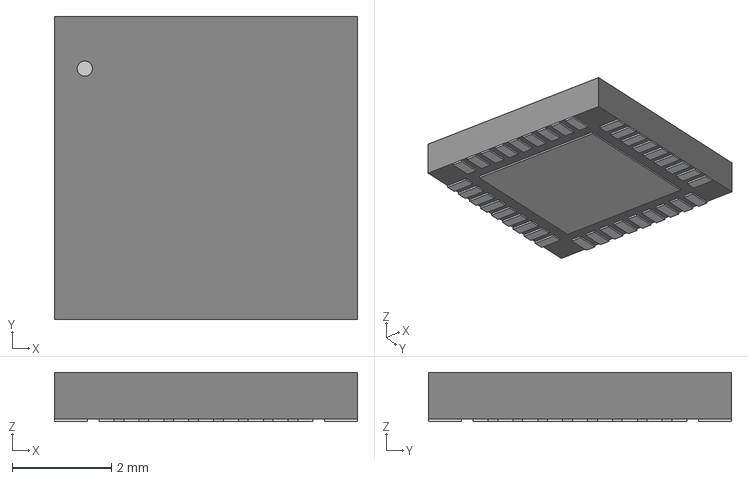
[picture p95: CAD file, 2025-01-15]
3dmodels/HVQFN36_SOT1092-2_NXP.step
6.10 x 6.10 x 0.993 mm
