CogniPilot/spinali_kicad_libs/3dmodels/TCR3UF20A_LM_CT.step

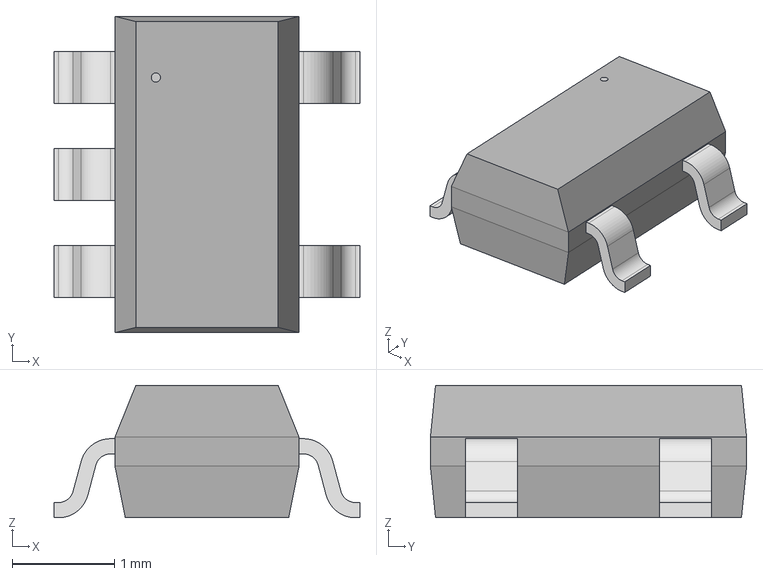
[picture p96: CAD file, 2025-01-14]
3dmodels/TCR3UF20A_LM_CT.step
3.00 x 3.10 x 1.30 mm
