CogniPilot/spinali_kicad_libs/3dmodels/MIC5504-1.8YMT-TR.step

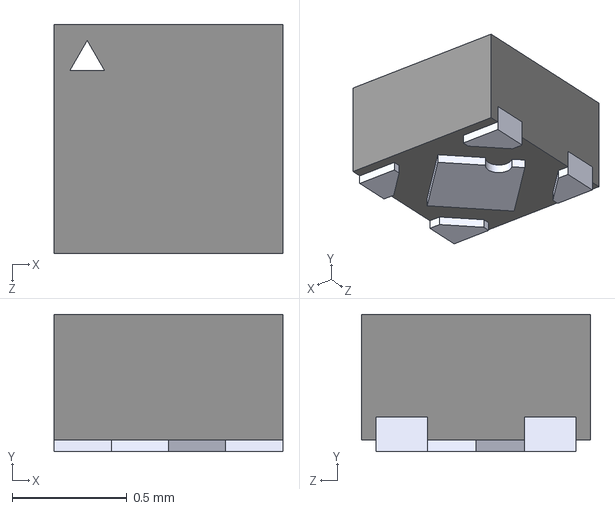
[picture p97: CAD file, 2025-01-14]
3dmodels/MIC5504-1.8YMT-TR.step
1.00 x 0.6 x 1.00 mm
