CogniPilot/spinali_kicad_libs/3dmodels/TJA1051TK.step

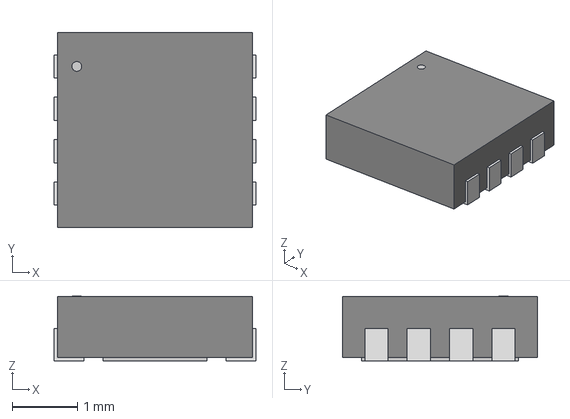
[picture p98: CAD file, 2025-01-14]
3dmodels/TJA1051TK.step
3.10 x 3.00 x 0.993 mm
