CogniPilot/spinali_kicad_libs/3dmodels/ICM-42688-P0.step

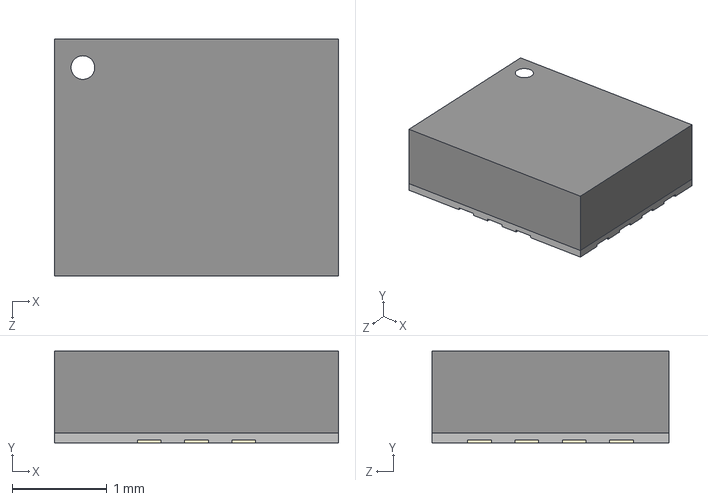
[picture p99: CAD file, 2025-01-14]
3dmodels/ICM-42688-P0.step
3.00 x 0.97 x 2.50 mm
