CogniPilot/spinali_kicad_libs/3dmodels/VL53L3CXV0DH.step

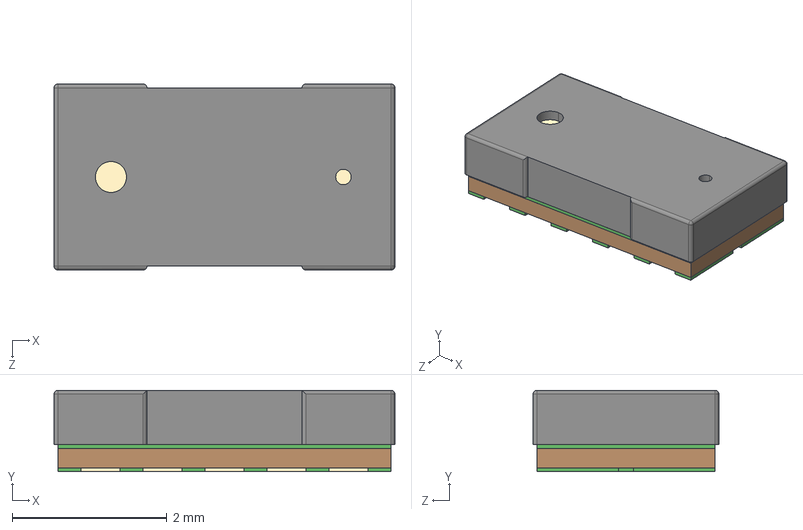
[picture p100: CAD file, 2025-01-14]
3dmodels/VL53L3CXV0DH.step
4.40 x 1.05 x 2.40 mm
