CogniPilot/spinali_kicad_libs/3dmodels/VL53L1CXV0FY.step

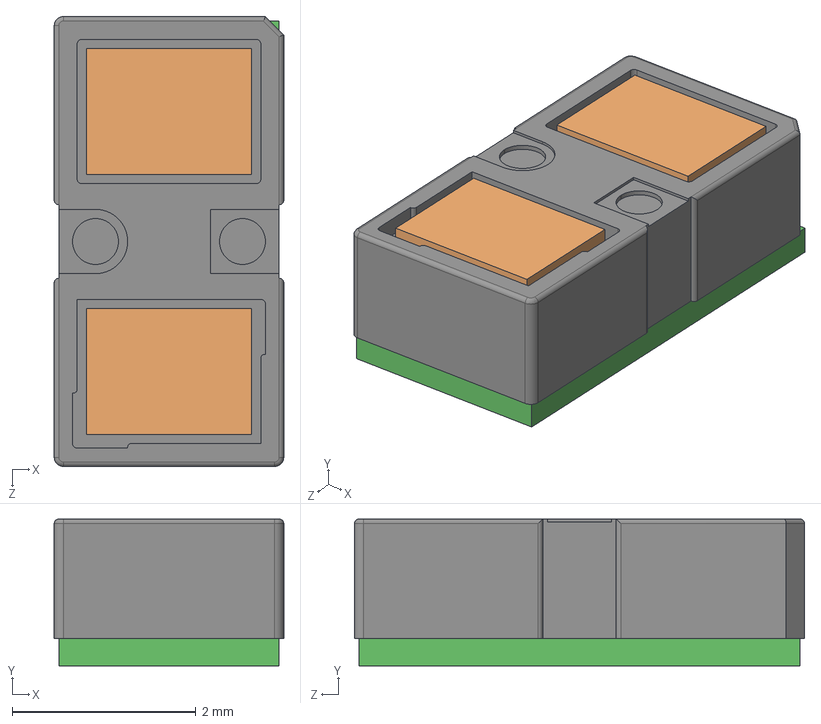
[picture p101: CAD file, 2025-01-14]
3dmodels/VL53L1CXV0FY.step
2.50 x 1.60 x 4.90 mm
