CogniPilot/spinali_kicad_libs/3dmodels/AFBR-S50xxxxx.step

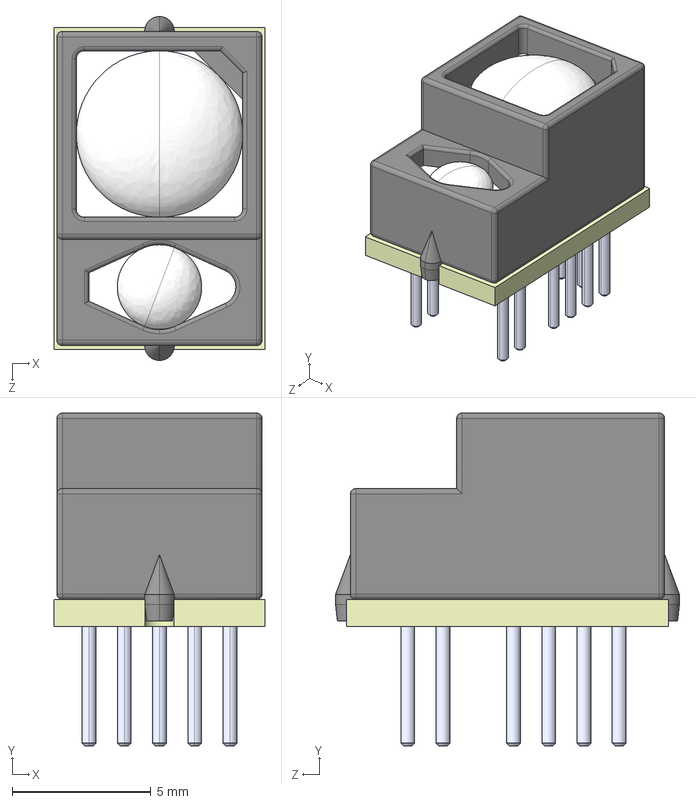
[picture p102: CAD file, 2025-01-14]
3dmodels/AFBR-S50xxxxx.step
7.60 x 12.0 x 12.4 mm
