CogniPilot/spinali_kicad_libs/3dmodels/VL53L8CHV0GC.step

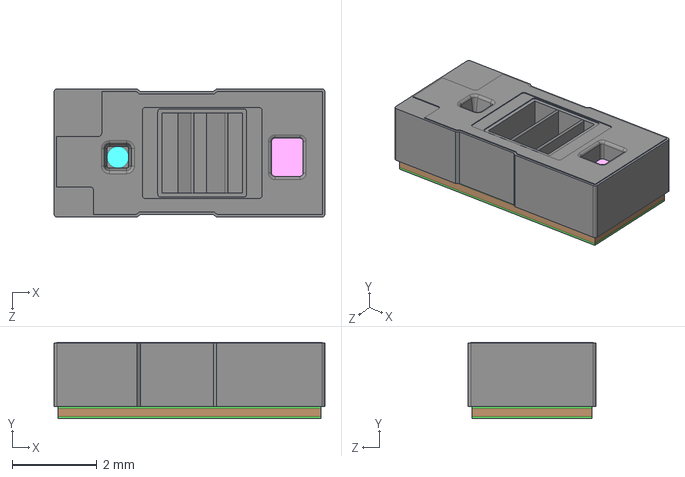
[picture p103: CAD file, 2025-01-14]
3dmodels/VL53L8CHV0GC.step
6.40 x 1.80 x 3.03 mm
