CogniPilot/spinali_kicad_libs/3dmodels/VL53L0X0.step

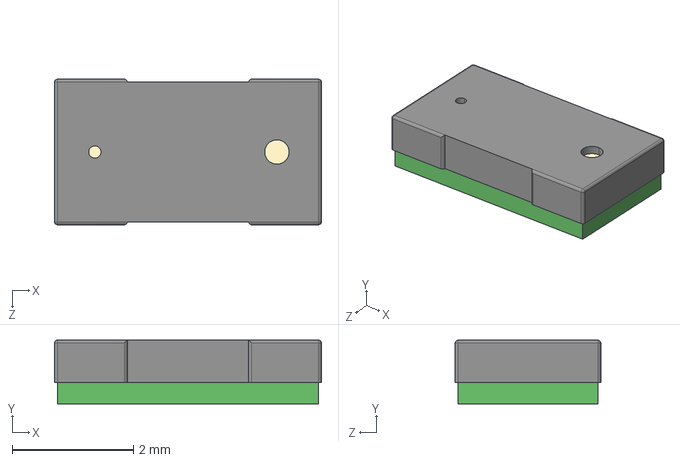
[picture p104: CAD file, 2025-01-14]
3dmodels/VL53L0X0.step
4.40 x 1.05 x 2.40 mm
