CogniPilot/spinali_kicad_libs/3dmodels/MPM3811GG.step

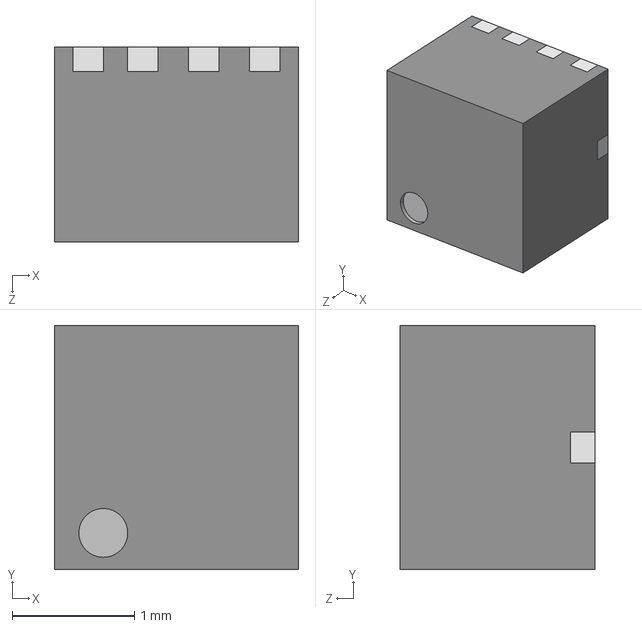
[picture p105: CAD file, 2025-01-14]
3dmodels/MPM3811GG.step
2.00 x 2.00 x 1.60 mm
