CogniPilot/spinali_kicad_libs/3dmodels/ICM-456860.step

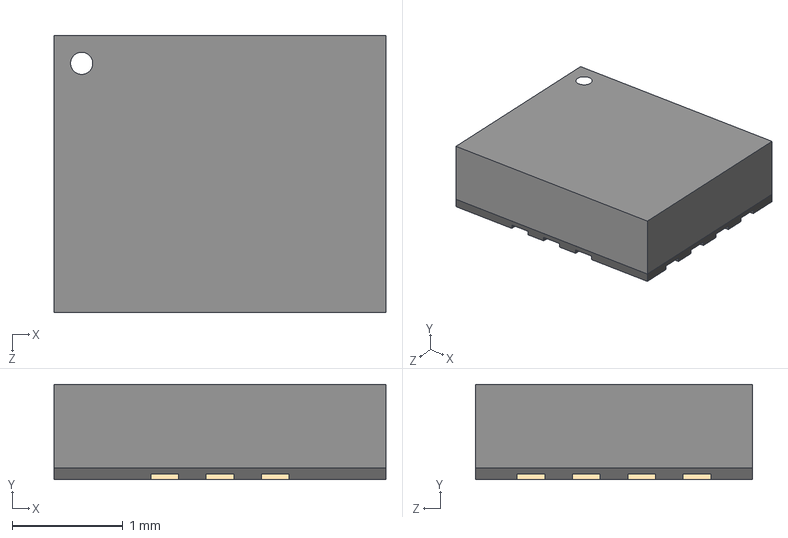
[picture p106: CAD file, 2025-01-14]
3dmodels/ICM-456860.step
3.00 x 0.86 x 2.50 mm
