CogniPilot/spinali_kicad_libs/3dmodels/TJA1462ATK.stp

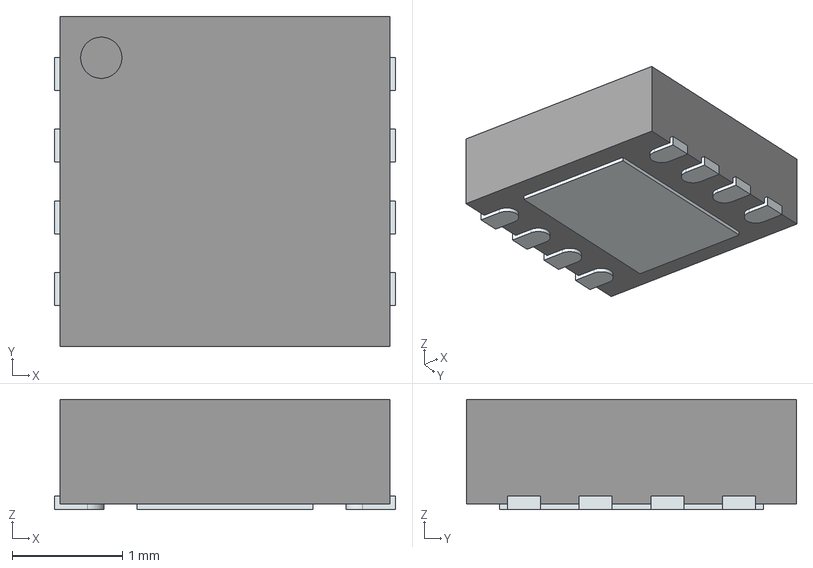
[picture p107: CAD file, 2025-01-14]
3dmodels/TJA1462ATK.stp
3.10 x 3.00 x 1.00 mm
ThermalPin
PinsArrayLR
