CogniPilot/spinali_kicad_libs/3dmodels/MCXN947VDFT.stp

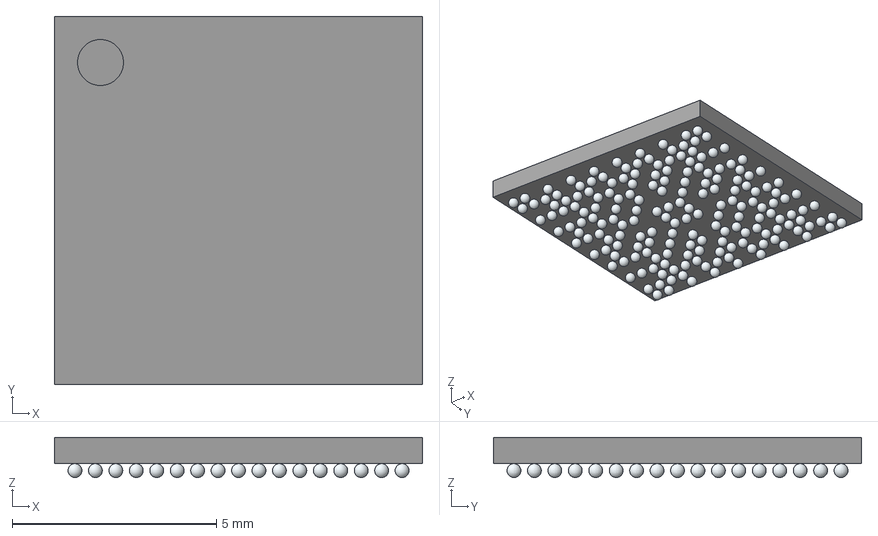
[picture p108: CAD file, 2025-01-13]
3dmodels/MCXN947VDFT.stp
9.00 x 9.00 x 0.98 mm
A1
A2
A4
A6
A8
A10
A12
A14
A16
A17
B1
B2
B3
B4
B6
B7
B8
B10
B11
B12
B14
B15
B16
B17
C3
C4
C5
C6
C8
C9
C10
C12
C13
C14
C15
D1
D2
D3
D4
D6
D7
D9
D11
D12
D14
D15
D16
D17
E4
E5
E7
E8
E10
E11
E13
E14
F1
F2
F3
F4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
