CogniPilot/spinali_kicad_libs/(list of files, cad)

Other CAD files:
3dmodels/436500212.stp
3dmodels/436500412.stp
3dmodels/5055750421.stp
3dmodels/5055780271.stp
3dmodels/5055780421_micro-lock_plus_4p.stp
3dmodels/5055780471.stp
3dmodels/830108212309.stp
3dmodels/LM66100DCKR.stp
3dmodels/Molex/170618829-659-0734120110/0734120110.stp
3dmodels/PN13101.STEP
3dmodels/PN13104.STEP
3dmodels/PN13156.STEP
