CogniPilot/spinali_kicad_libs/(commit log)

2025-01-13 Created initial .gitignore to ignore kicad backup files
2025-01-13 Created symbol and footprint for PAA3905E1-Q
2025-01-14 Restructured library to be uniform to Kicad. Grouped symbols and footprints.
    [AFBR-S50LV85D0.step, ICM-42688-P0.step, ICM-456860.step, LM66100DCKR.stp, MCXN947VDFT.stp, MIC5504-1.8YMT-TR.step, MPM3811GG.step, TCR3UF20A_LM_CT.step]
2025-01-15 Added 3d model for PAA3905. Created symbols, footprints and 3d models for the following parts: TJA1103AHN, PAT9136, SK9822-EC20, BMP390, AFBR-S50LX85D.
    [10LGA_2X2X0p75_BOS.step, AFBR-S50xxxxx.step, HVQFN36_SOT1092-2_NXP.step, PAA3905.step, PAT9136.step, SK9822-EC20.stp]
2025-01-20 Added symbol, footprint and 3D model for MFS2633AMBA0AD PMIC
    [MFS2633AMBA0AD.stp]
2025-02-22 Add connectors.
    [436500212.stp, 436500412.stp, 5055750421.stp, 5055780271.stp, 5055780471.stp, DF40C-30DP-0.4V_51_.stp]
2025-03-12 Update library
    Added new parts:
    - Added BUK6D56-60EX
    - Added ACP3225-102-2P-T000
    - Added LM5160DNTJ
    - Added VLS5045EX-330M-H
    - Added NXP5P3363
    - Added GRM1885C2A102JA01D
    - Added 6DFN62CA-M3/I
    Removed MFS2633AMBA0AD part
    [ACP3225-102-2P-T000.stp, BUK6D56-60EX.stp, LM5160DNTJ.stp, MFS2633AMBA0AD.stp, MPM3822CGRH.step, NX5P3363UKZ.stp, VLS5045EX-330M-H.stp, VQFN32_PHA_MCH.step]
2025-03-12 Added parts to library
    Added BMM350, BMP581 and NFM31KC153R1H3L part to library.
    [BMM350.stp, BMP581.stp, NFM31KC153R1H3L.stp]
2025-03-12 Added parts to library
    Added IFLN1210BEER512N, PESD2IVN24-UX, CRCW060360R4FKEAHP and VETH100A203S-G3-18 to library.
    [PESD2IVN24-UX.stp]
2025-03-12 Updated parts
    Updated symbol of PESD2IVN24-UX and VETH100A203S-G3-18. Removed unnecessary footprint.
2025-03-13 Added 3D model
    Added 3D model for IFLN1210BEER512N.
    [IFLN1210BEER512N.stp]
2025-03-18 Added parts
    Added the following parts to the library:
    - Micro lock plus 4 pins
    - ACM7060-301-2PL-TL01
    - DF40TC 50 pins, including height variants.
    - ESD7104MUTAG
    - NANOT160AS
    - XRCGB25M000F3A00R0
    - TS2306A
    [5055780421_micro-lock_plus_4p.stp, ACM7060-301-2PL-TL01.stp, DF40TC(2.5)-50DS-0.4V(51).stp, DF40TC(3.0)-50DP-0.4V(51).STEP, DF40TC(4.0)-50DS-0.4V(51).stp, DF40TC-50DP-0.4V(51).stp, DF40TC-50DS-0.4V(51).stp, ESD7104MUTAG.stp]
2025-03-19 Updated silkscreen ref text size
    Updated all silkscreen reference text size to 1x1mm with 0.15mm width.
2025-03-20 Added parts to library
    - Added 3D model for 6DFN62CA-M3_I
    - Added 3D model for 830108212309
    - Added PCMF1USB3SZ part
    - Added 3D model for SM10B-SRSS-TB_LF__SN_
    - Added TS2306A part
    - Added PESD1USB3BCX part
    - Added PESD5V0S1ULD315 part
    [6DFN62CA-M3_I.stp, 830108212309.stp, PCMF1USB3SZ.stp, PCMF3USB3S_CZ.stp, PESD5V0S1ULD,315.stp, SM10B-SRSS-TB_LF__SN_.stp, TS2306A-240GF-MSM-9_C388290.stp]
2025-03-26 Added ACT1210L-201-2P-TL00 part
    [ACT1210L-201-2P-TL00.stp]
2025-04-07 Updated ICM-45686 symbol and added compass arrow silkscreen
    Made pin 7 of ICM-45686 visible again.
    Added compass arrow silkscreen image.
2025-04-07 Updated MIC5504-3.3YMT footprint
    Fixed solder mask to be the same as default.
2025-04-09 Updated footprints
    Updated footprint of 5055780421 and 5055780471 connectors so the silkscreen dot is only on one side.
2025-04-23 Updated ICM-42688-P
    - Updated footprint to correct layout as depicted in datasheet.
    - Added 3D model for ICM-42688-P.
    [ICM-42688-P.stp]
2025-04-23 Updated footprints
    Added XY axis on Fab layer for ICM-42688, ICM-45686 and PAA3905E1-Q.
2025-04-24 Updated PAA3905E1-Q
    Added improved 3D model.
    [PAA3905E1-Q.STEP]
2025-04-24 Updated NanoTxxxAS footprint
    Changed thermal relief spoke angle of pads to 90 degrees.
2025-05-20 Added JK3030AWT-P-U50EA footprint
2025-06-10 added parts
    Added BATTERY-RPI with mounting tab connections
    One other additio
2025-07-10 Added GNSS parts
    - Added NEO-F9P-15B
    - Added RM3100
    [NEO-F9P-15B.stp]
2025-08-21 Adds kicad add_lib tool.
2025-08-21 add panasonic switch
    [EVQPU-LC-02K.STEP]
2025-08-25 Right angle JST SH connectors
    ADD
    [BM02B-SRSS-TB.STEP, BM03B-SRSS-TB.STEP, BM04B-SRSS-TB.STEP, BM05B-SRSS-TB.STEP, BM06B-SRSS-TB.STEP, BM07B-SRSS-TB.STEP, BM08B-SRSS-TB.STEP, BM09B-SRSS-TB.STEP]
2025-09-04 Add PNI 3d models (#4)
    [PN13101.STEP, PN13104.STEP, PN13156.STEP]
2025-09-17 add new 3d footprints
    add new 3d footprints
    [0734120110.stp]
2025-09-18 add switch and connector (#5)
2026-08-28 Improved DF40TC silkscreen and Battery connector symbol data
    - Changed silkscreen text size of designator of all DF40TC connectors to 1mmx1mm with 0.15mm width.
    - Added correct BOM data to battery connector symbol.
